kumaokobo/kudox-keyboard/README.md

# Kudox & Kudox Game Keyboards

<p align="center">
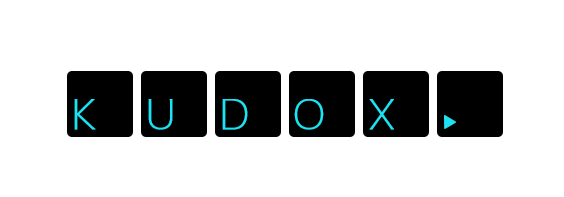
[picture p1: img/kudox.png]
Kudox logo

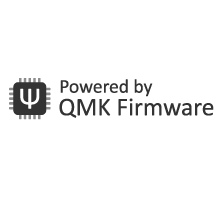
[picture p2: img/qmk-badge-light-square.png]
QMK

</p>

7x5 Row-Staggered layout keyboards.  
Powered by [QMK (Quantum Mechanical Keyboard Firmware)](https://github.com/qmk/qmk_firmware).

<p align="center">
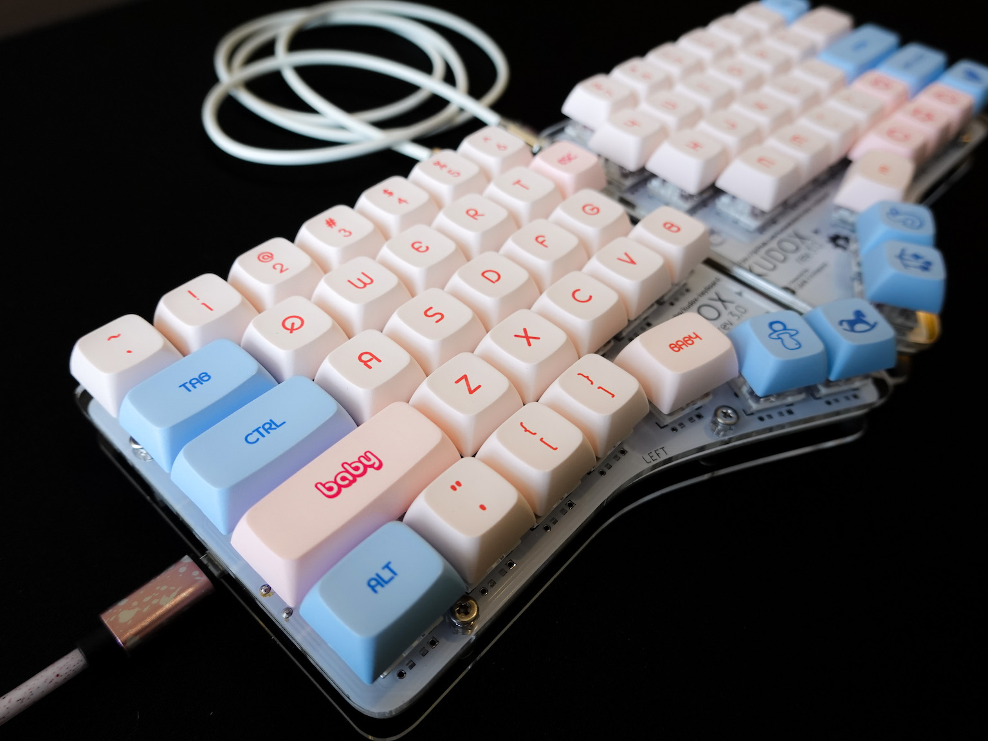
[picture p3: img/kudox-rev3-image3.jpg]
Kudox rev3 image

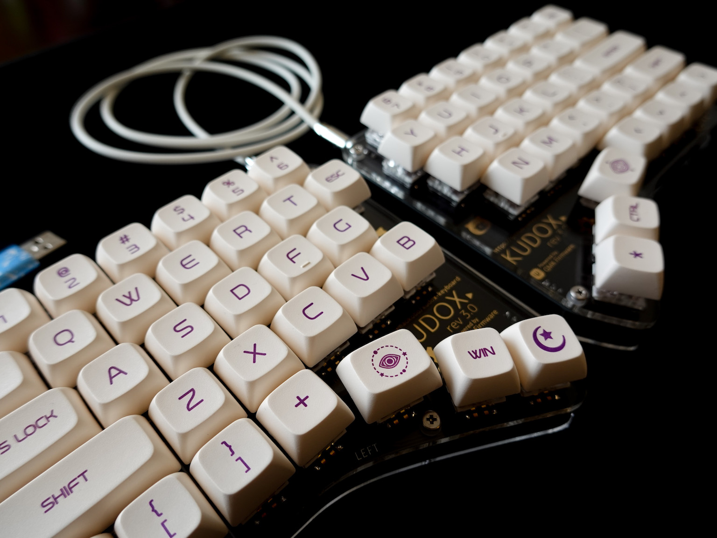
[picture p4: img/kudox-rev3-image4.jpg]
Kudox rev3 image

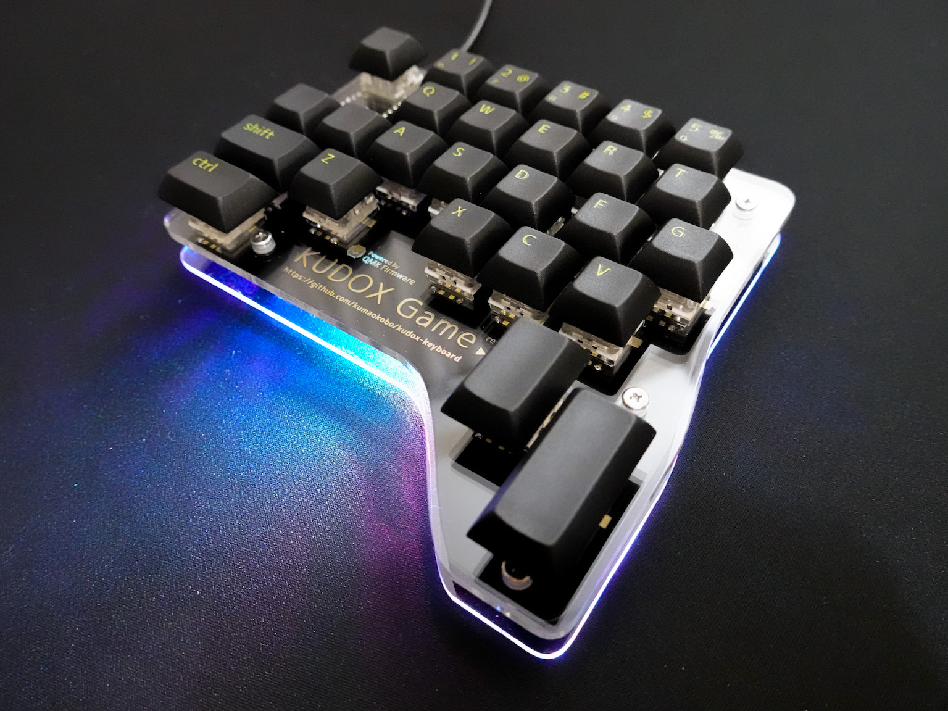
[picture p5: img/kudox-game-led1.jpg]
Kudox Game Rev2 image

</p>

## Documents

### Kudox Keyboard
- [English](./kudox/README.md)
- [Japanese](./kudox/README.ja.md)

### Kudox Game Keyboard
- [English](./kudox-game/README.md)
- [Japanese](./kudox-game/README.ja.md)

### Kudox Keyboard Columner Type
- [English](./kudox-columner/README.md)
- [Japanese](./kudox-columner/README.ja.md)

# Acknowledgements

Kudox keyboard was forked from [Redox keyboard](https://github.com/mattdibi/redox-keyboard).

# License

<br /><span xmlns:dct="http://purl.org/dc/terms/" property="dct:title">Kudox * Keyboards</span> by <a xmlns:cc="http://creativecommons.org/ns#" href="https://github.com/kumaokobo" property="cc:attributionName" rel="cc:attributionURL">Kumao Kobo</a> is licensed under a <a rel="license" href="http://creativecommons.org/licenses/by-nc-sa/4.0/">Creative Commons Attribution-NonCommercial-ShareAlike 4.0 International License</a>.
