kumaokobo/kudox-keyboard/kudox-game/README.md

# Kudox Game Keyboard

The Kudox Game is a keyboard specialized for playing game.  
It uses [QMK Firmware](https://github.com/qmk/qmk_firmware) and can be assigned `Ctrl-C`, `Ctrl-V` and so on to one key.  

**Japanese Manual is [here](README.ja.md).**

## Rev 1.0

Rev 1.0 needs to solder switches on PCB.  

<div style="display:block;margin:50px auto;">
<p align="center">
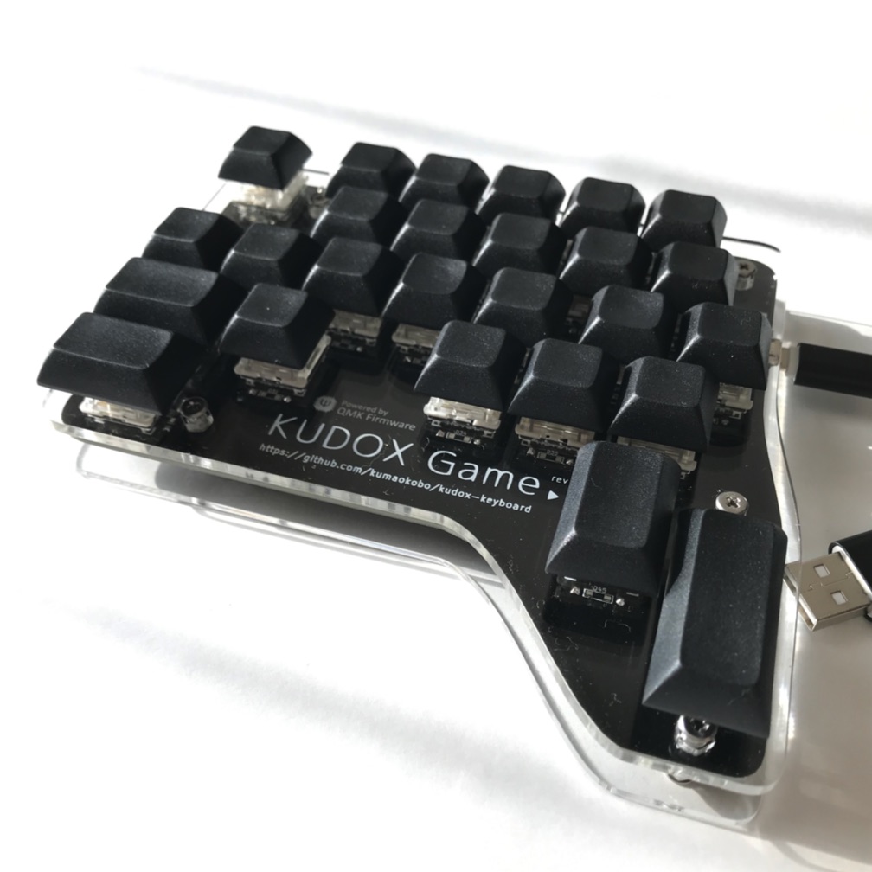
[picture p40: img/kudox-game-pcb.jpg]
Kudox Game image

</p>
</div>

- [Rev1.0 Assembly Guide](./rev1/README.md)

### Youtube: Videos

- [Inken ch](https://www.youtube.com/channel/UCXJZdip7JmW74HQHCtfYzFw) (*Japanese only*)

<p align="center">
<a href="https://www.youtube.com/watch?v=f3dFaBmC-ak">Kudox Game組み立てガイド</a>
<a href="https://www.youtube.com/watch?v=HCa4KX-FlOU">Kudox Game Firmware</a>
<a href="https://www.youtube.com/watch?v=UFQ--JORdnw">Kudox Game Playing Video</a>
</p>
</p>

## Rev 2.0

Rev 2.0 is compatible with switch hot-swapping, users can change easily switches and adjust responsibility per keys.  
As hot-swap sockets need to be soldered, it is slightly more difficult to assemble than Rev 1.0.  

<div style="display:block;margin:50px auto;">
<p align="center">
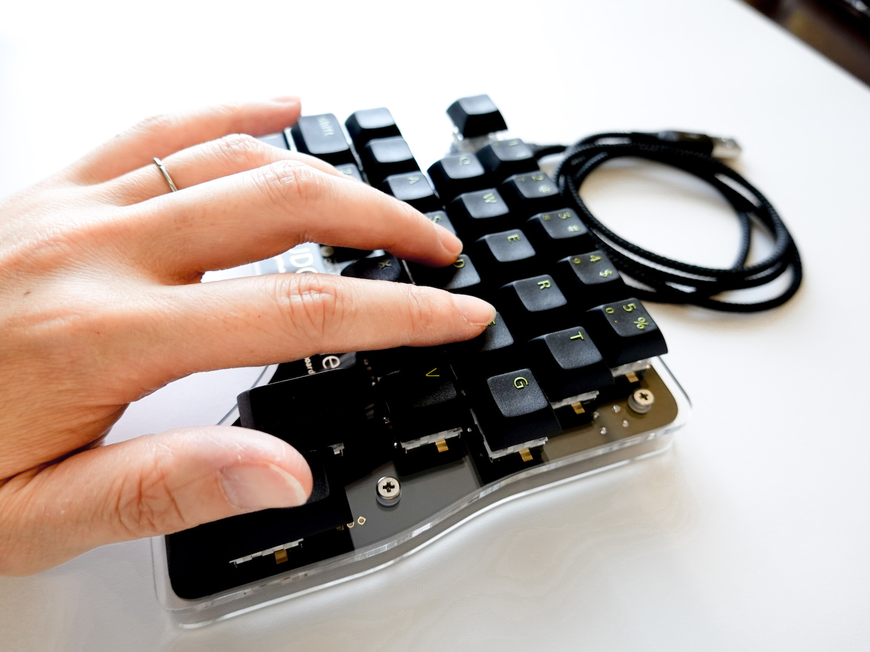
[picture p41: img/kudox-game-rev2-image1.jpg]
Kudox Game Rev2 image1

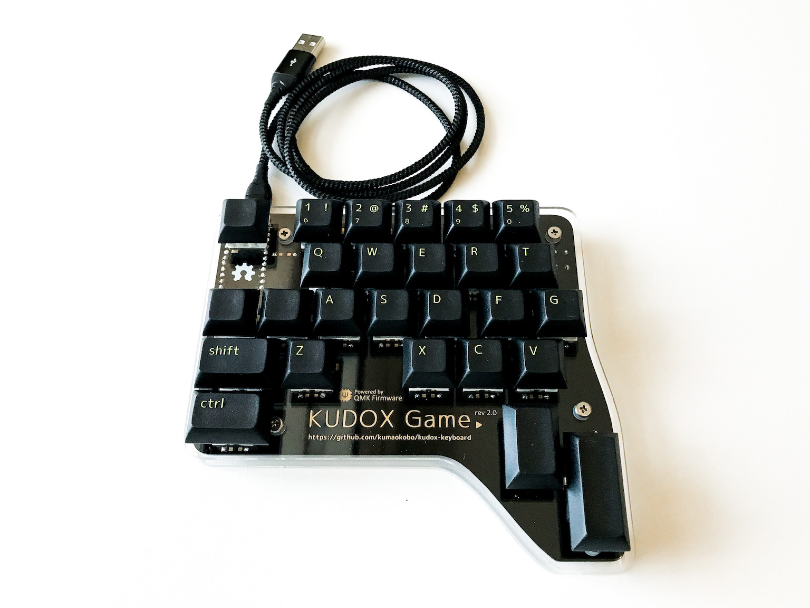
[picture p42: img/kudox-game-rev2-image2.jpg]
Kudox Game Rev2 image2

</p>
</div>

- [Rev2.0 Assembly Guide](./rev2/README.md)

# License

<br /><span xmlns:dct="http://purl.org/dc/terms/" property="dct:title">Kudox Game Keyboard</span> by <a xmlns:cc="http://creativecommons.org/ns#" href="https://github.com/kumaokobo" property="cc:attributionName" rel="cc:attributionURL">Kumao Kobo</a> is licensed under a <a rel="license" href="http://creativecommons.org/licenses/by-nc-sa/4.0/">Creative Commons Attribution-NonCommercial-ShareAlike 4.0 International License</a>.
