kumaokobo/kudox-keyboard/kudox/README.md

# Kudox Keyboard

The Kudox is the Row-Staggered split keyboard.  
**Japanese Manual is [here](README.ja.md).**

## Rev 1.0

Rev 1.0 is standard 64 key Row-Staggered split keyboard.  

<div style="display:block;margin:50px auto;">
<p align="center">
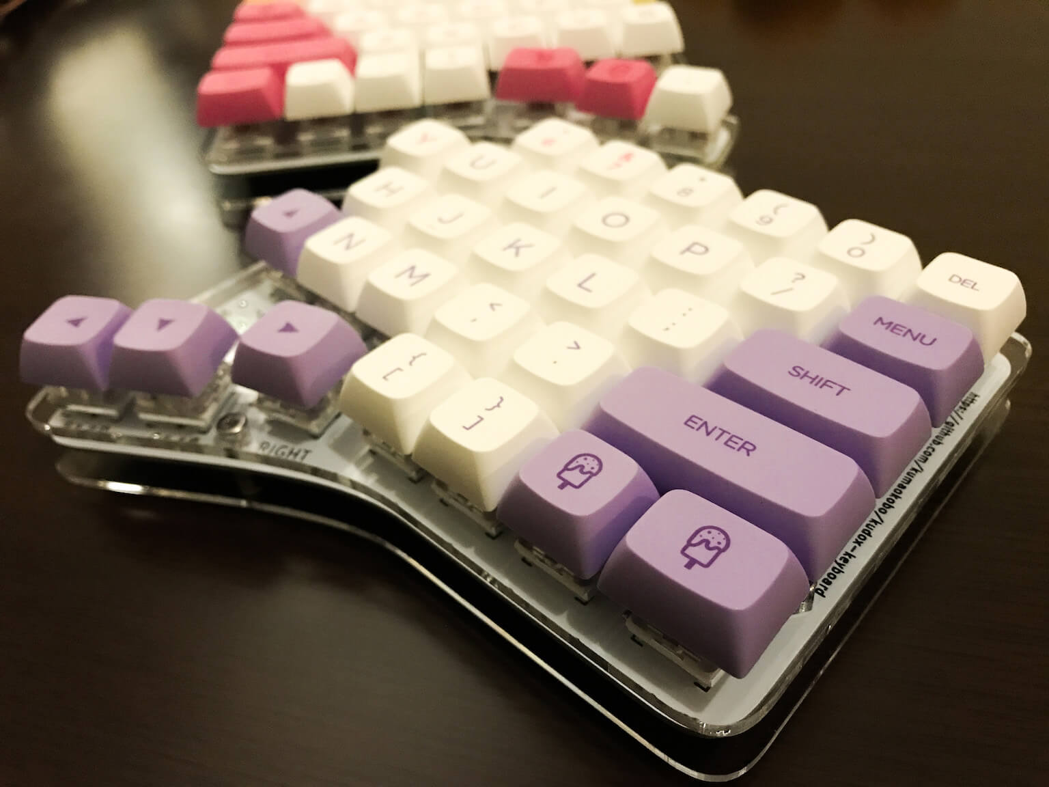
[picture p43: img/kudox-pcb.jpg]
Kudox image

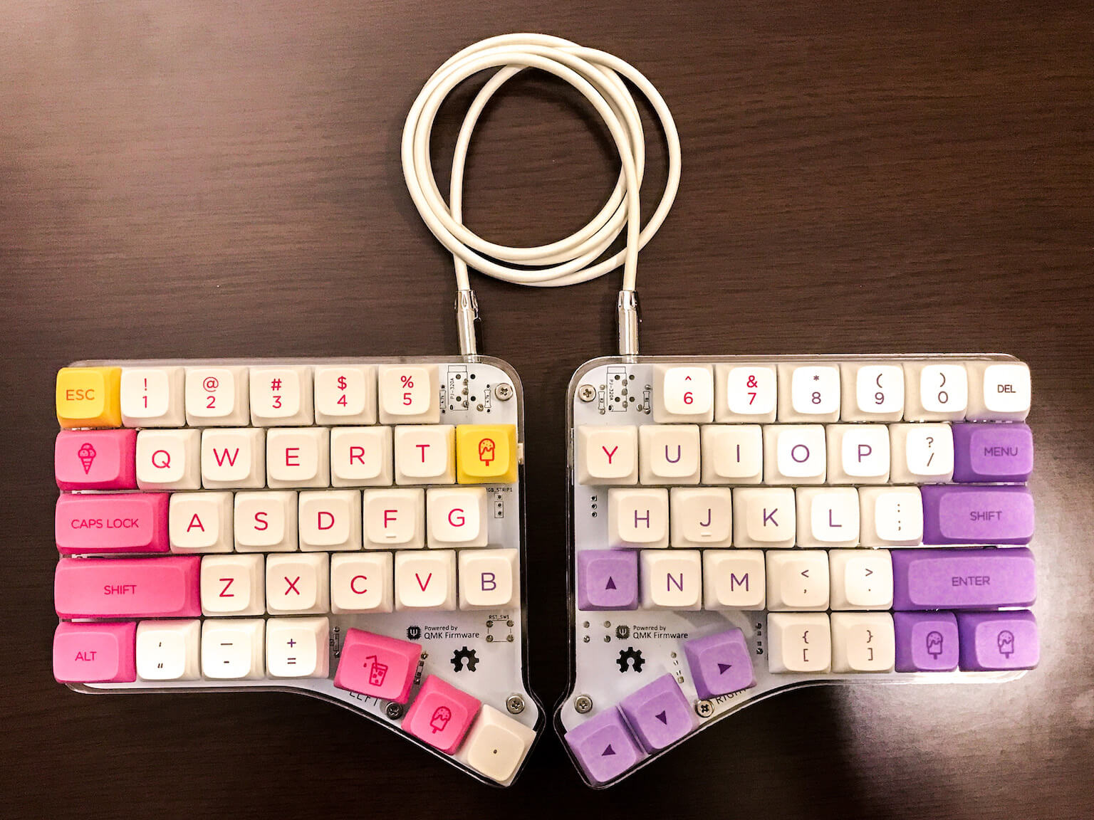
[picture p44: img/kudox-image-rev1.jpg]
Kudox image1

</p>
</div>

- [Rev1.0 Assembly Guide](./rev1/README.md)

## Rev 2.0

Rev 2.0 is hot-swappable 66 key split keyboard.  
As hot-swap sockets need to be soldered, it is slightly more difficult to assemble than Rev 1.0.  

<div style="display:block;margin:50px auto;">
<p align="center">
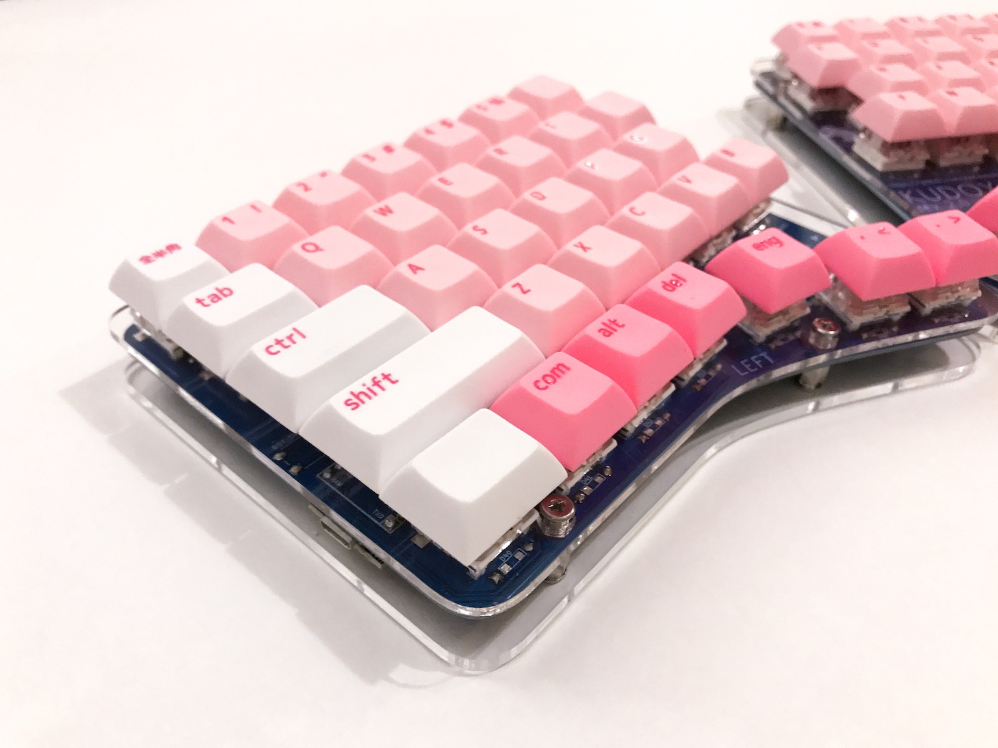
[picture p45: img/kudox-rev2-image1.jpg]
Kudox rev2 image1

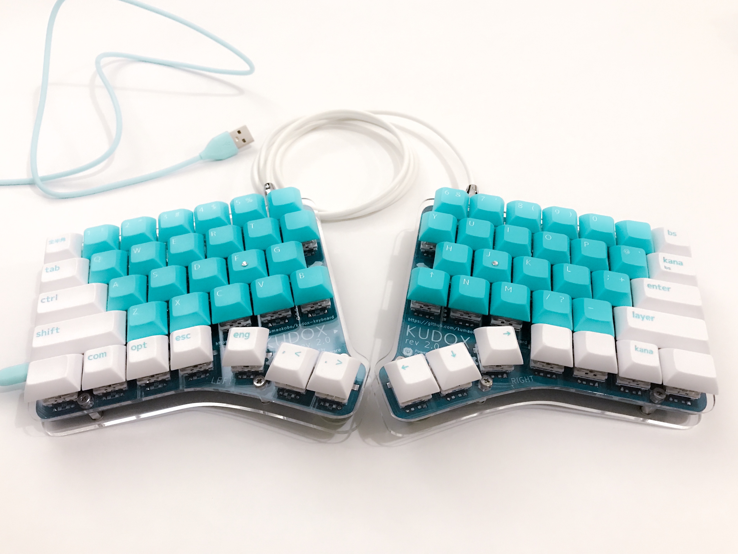
[picture p46: img/kudox-rev2-image2.jpg]
Kudox rev2 image2

</p>
</div>

- [Rev2.0 Assembly Guide](./rev2/README.md)

## Rev 3.0

Rev 3.0 supports both hot swap sockets and direct switch mounting.  
Also, we divided the board design for right hand and left hand.  
For this reason, the key columns become more normal row-staggered.  

<div style="display:block;margin:50px auto;">
<p align="center">
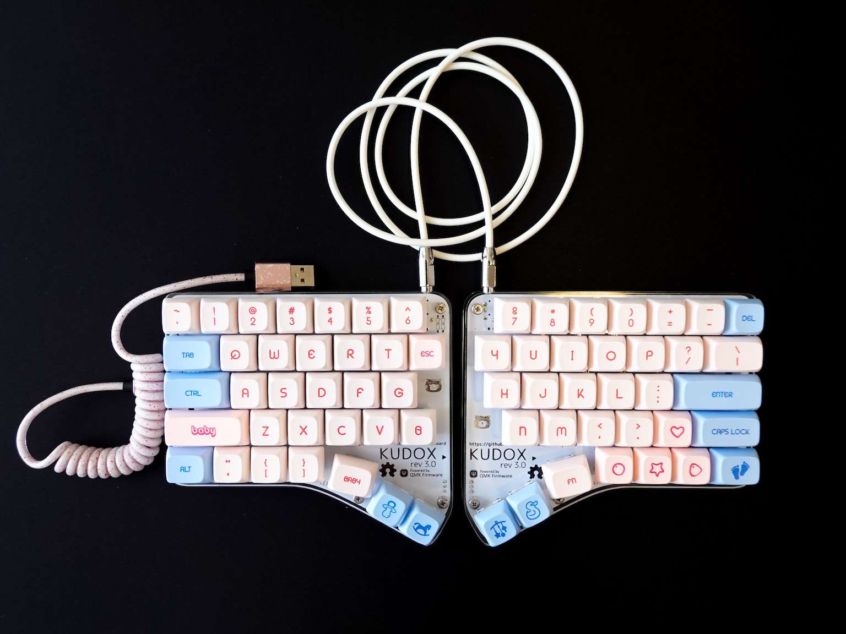
[picture p47: img/kudox-rev3-image1.jpg]
Kudox rev3 image1

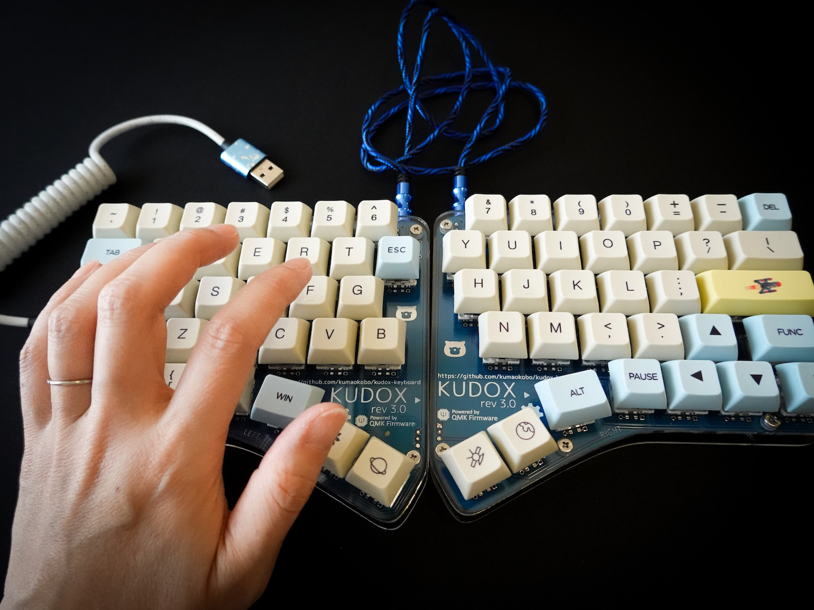
[picture p48: img/kudox-rev3-image2.jpg]
Kudox rev3 image2

</p>
</div>

- [Rev3.0 Assembly Guide](./rev3/README.md)

### Video guides

- [Inken ch](https://www.youtube.com/channel/UCXJZdip7JmW74HQHCtfYzFw) (japanese only)

<p align="center">
<a href="https://www.youtube.com/watch?v=6zZAXjMQ80E">Kudox assembly guide</a>
<a href="https://www.youtube.com/watch?v=HCa4KX-FlOU">Kudox Firmware</a>
</p>

# License

<br /><span xmlns:dct="http://purl.org/dc/terms/" property="dct:title">Kudox Keyboard</span> by <a xmlns:cc="http://creativecommons.org/ns#" href="https://github.com/kumaokobo" property="cc:attributionName" rel="cc:attributionURL">Kumao Kobo</a> is licensed under a <a rel="license" href="http://creativecommons.org/licenses/by-nc-sa/4.0/">Creative Commons Attribution-NonCommercial-ShareAlike 4.0 International License</a>.
