kumaokobo/kudox-keyboard/kudox-game/rev2/README.ja.md

# Kudox Game Keyboard Rev2.0

Kudox Game Rev2.0 は ゲーム・プレイに特化した片手用キーボードです.  
スイッチ・ホットスワップを採用し, スイッチの入れ替えを容易にすることで, キー毎に反応のし易さや打鍵感を調整できるようにしました.  
また キー・コードを自由にレイアウトできる [QMK Firmware](https://github.com/qmk/qmk_firmware) を利用しているので, `Ctrl-C` や `Ctrl-V` などの合成キーを1キーに割り当てられるようになっています.  

**English Manual is [here](README.md).**

<p align="center">
Kudox Game image&nbsp;
Kudox Game Rev2
</p>

## Summary

  - [必要な部品](#必要な部品)
  - [組み立てガイド](#組み立てガイド)
  - [LEDテープの取り付け](#LEDテープの取り付け)
  - [ファームウェア](#ファームウェア)
    - [コンパイル＆書き込みコマンド](#コンパイル＆書き込みコマンド)
    - [VIAを使ったキーマップ変更](#VIAを使ったキーマップ変更)

## 必要な部品

| 数量 | 項目 | 備考 |
|----:|---|---|
| 1 | Kudox Game Rev2 | |
|  26 | 1N4148 ダイオード | SMD ダイオードでも可. |
|  26 | [Kailh PCB Scoket](https://www.kailhswitch.com/mechanical-keyboard-switches/box-switches/mechanical-keyboard-switches-kailh-pcb-socket.html) | Cherry MX 互換タイプの方 |
| 1 | タクトスイッチ | 6mm x 6mm x 4.3mm サイズのもの. |
| 1 | Arduino ProMicro | マイコン: ATMega32U4 |
| 1 | USB micro ケーブル | 家に落ちているもので可. |
| 1 | ケース | |
| 5 | ネジ M3 x 10mm | M3 |
| 5 | ネジ M3 x  5mm | M3 |
| 5 | スペーサー | M3 |
| 5 | ワッシャー | M3 |
|  26 | Cherry MX 互換スイッチ | お好みで...💕 |
|  26 | Cherry MX 互換 キーキャップ | 3x 1.5u, 1x 2u, 22x 1u |

キーキャップとスイッチ以外の全てを含む [Kudox Game Rev2 基本セット](https://manage.booth.pm/items/1917685) を [BOOTH](https://kumaokobo.booth.pm/) にて販売しています.  

## 組み立てガイド

<p align="center">
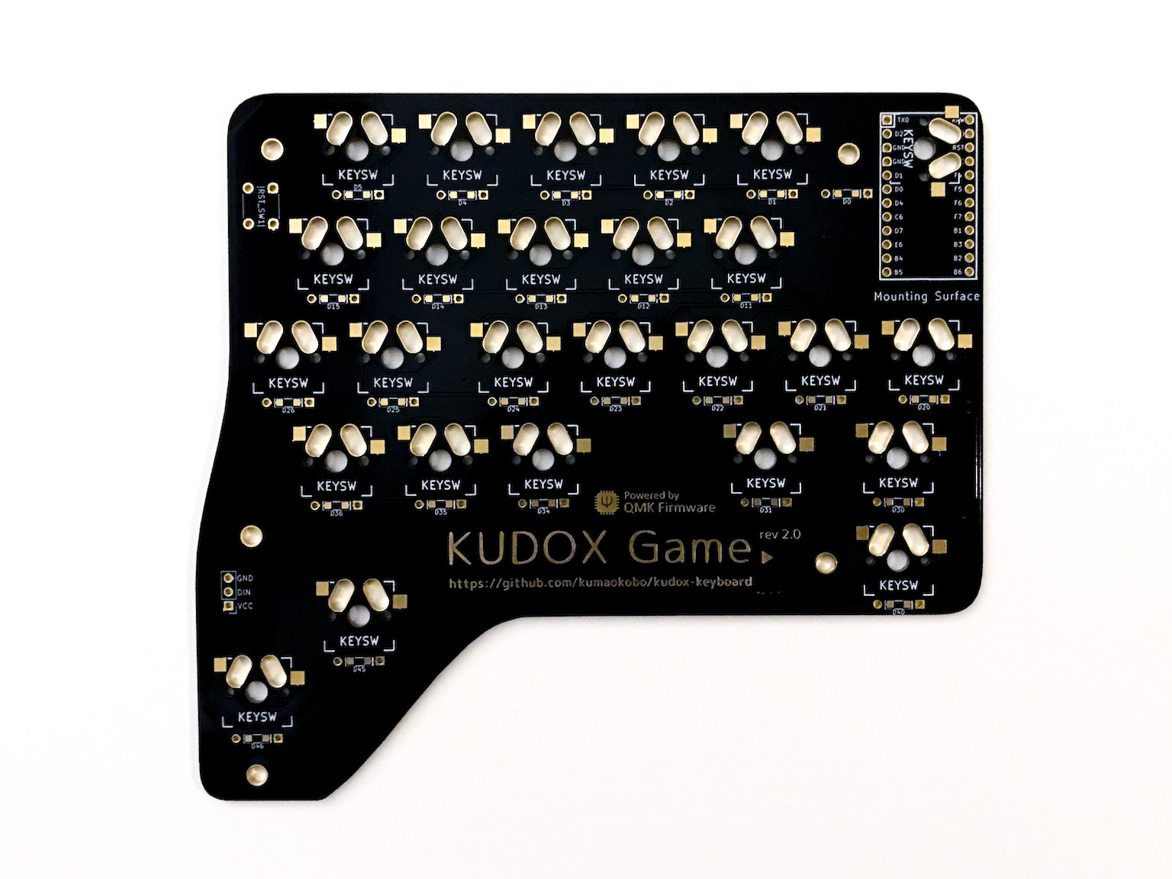
[picture p49: img/kudox-game-rev2-pcb.jpg]
Kudox Game Rev2 PCB

</p>

- PCB の `Mounting Surface` と記載のある側に電子部品をはんだ付けします:
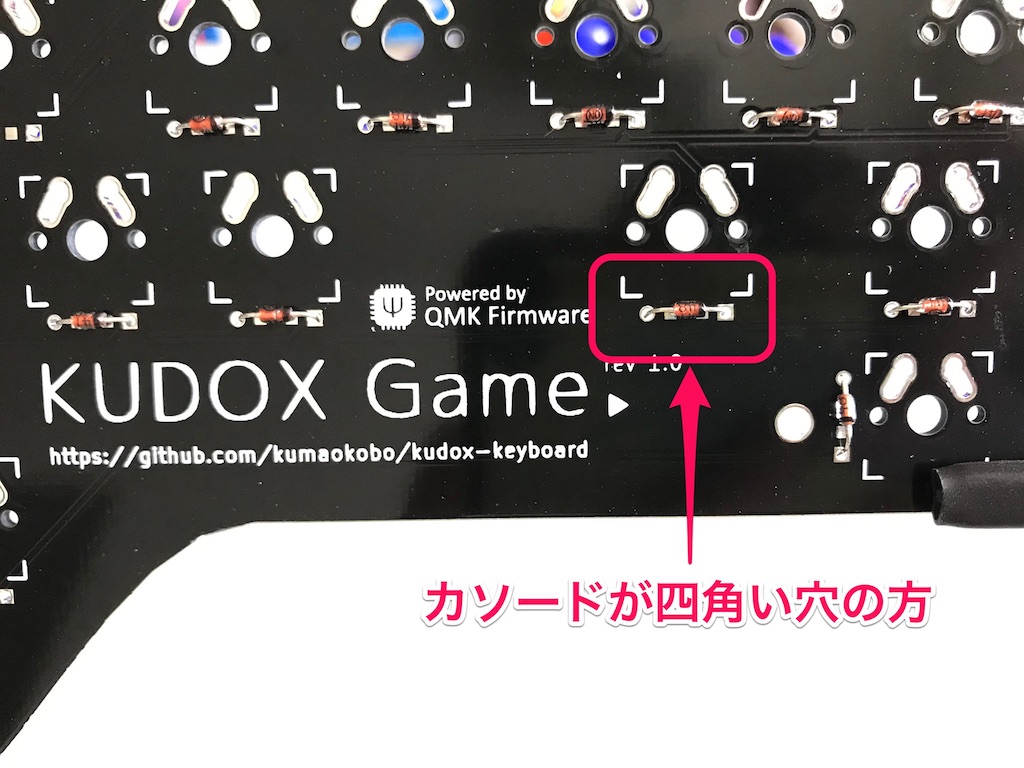
[picture p50: img/kudox-game-diode.jpg]
Kudox Game diode
  1. 1N4148ダイオード (向きがあります. カソードが四角い穴側にくるように差します)<br/>*多くのダイオードではカソード側に線などが入っています*
  2. タクトスイッチ
  3. ホットスワップ・ソケット<div>soldering hot swap sockets</div>下記の動画で詳しく紹介しています: <br/><div><a href="https://www.youtube.com/watch?v=uHqkW0cQ80I">ホットスワップソケットの付け方</a></div>[[YouTube] インケンch: ホットスワップソケットの付け方](https://www.youtube.com/watch?v=uHqkW0cQ80I)<br/>クリームはんだでリフローして頂いてももちろん大丈夫です.
  4. ProMicro の ピン・ヘッダ
- パーツの足をカットします.  
  *※ 特に ProMicro のピン・ヘッダはスイッチに干渉しやすいのでできるだけ短くカットしてください*
- ProMicro を ピン・ヘッダにはんだ付けします.  
  <span><em>※ ProMicro は表向き(チップが見えるように)に実装します. (rev1と逆になります)</em></span>
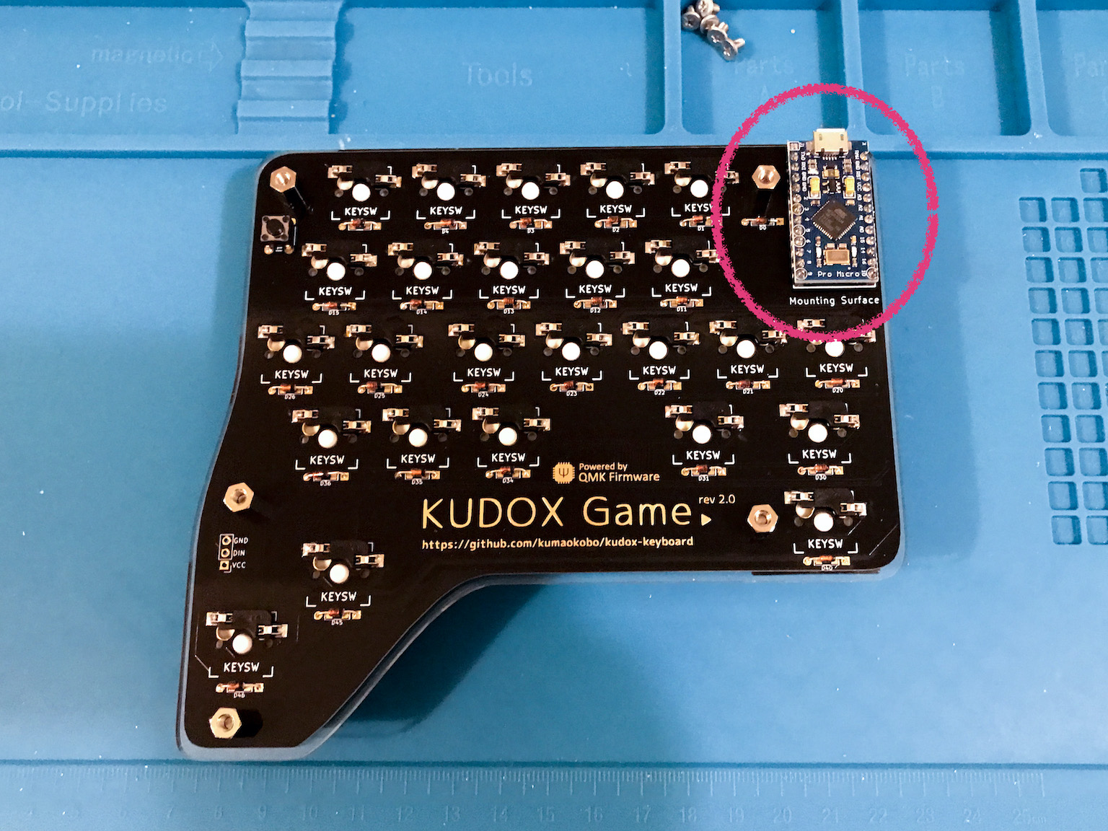
[picture p51: img/kudox-game-rev2-promicro.jpg]
Kudox Game Rev2 ProMicro
  
- PCB に上部ケースを取り付けます.  
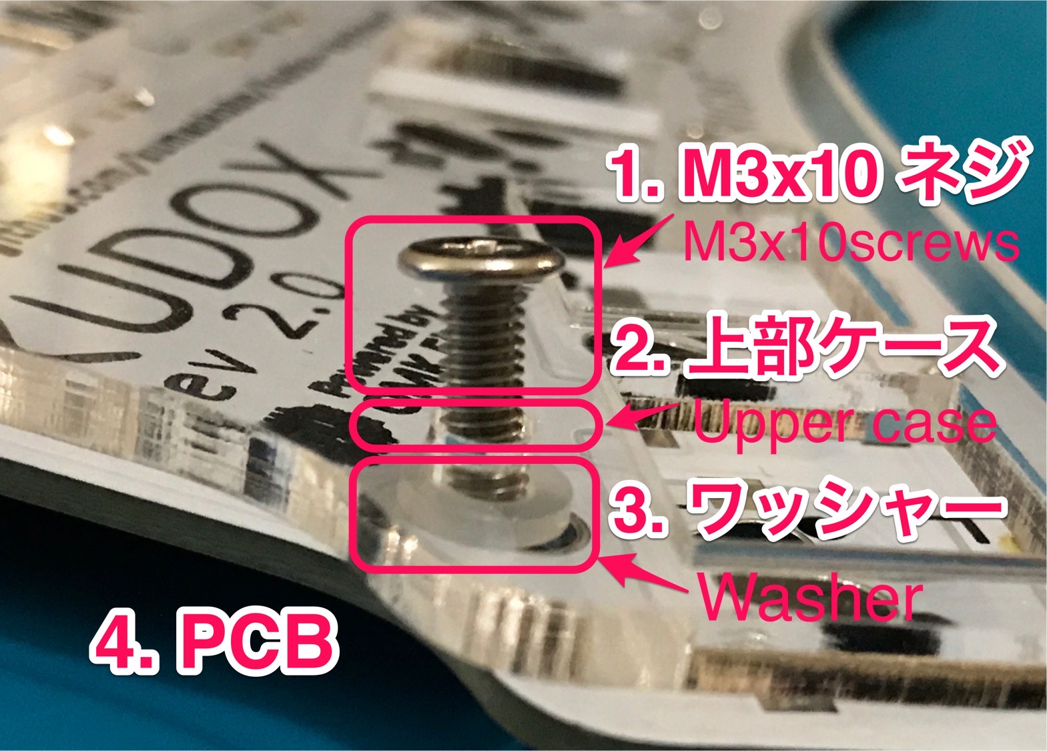
[picture p52: img/kudox-case-hotswap.jpg]
Kudox Game Case
  M3ネジ(10mm) → 上部ケース → M3ワッシャー → PCB → スペーサー の順番に取り付けます.<br/>
- M3ネジ(5mm)で下部ケースとスペーサーを止めます.
- スイッチを嵌めて完成です.<div>
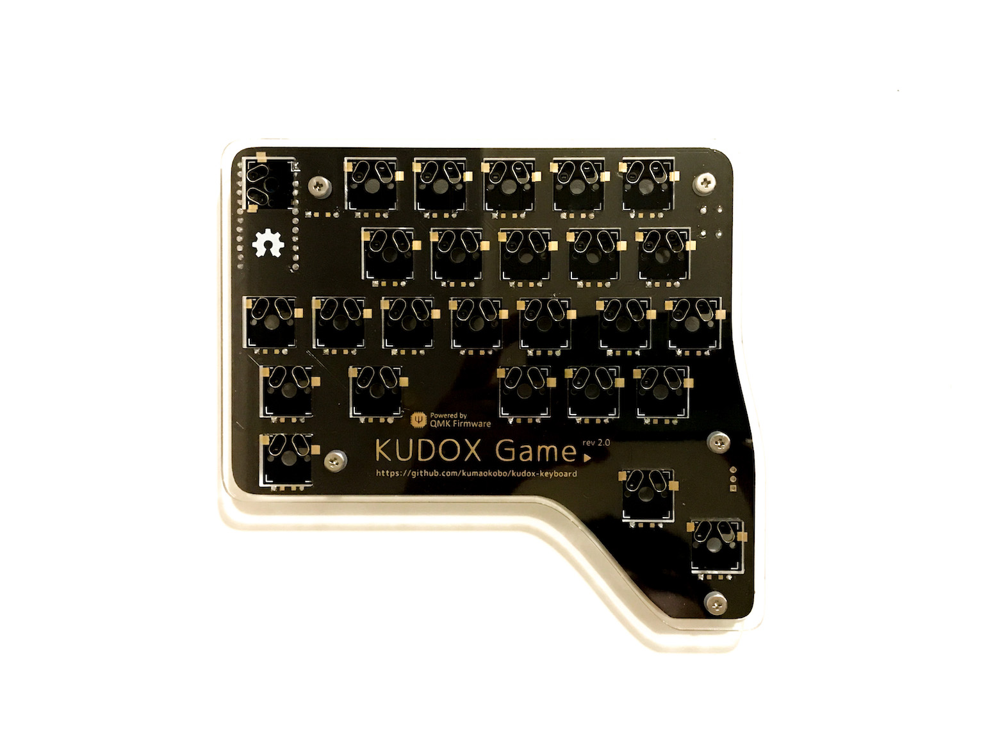
[picture p53: img/kudox-game-rev2-assembly-case-1.jpg]
assembly kudox game rev2 case 1
  <span>&nbsp;&nbsp;</span>
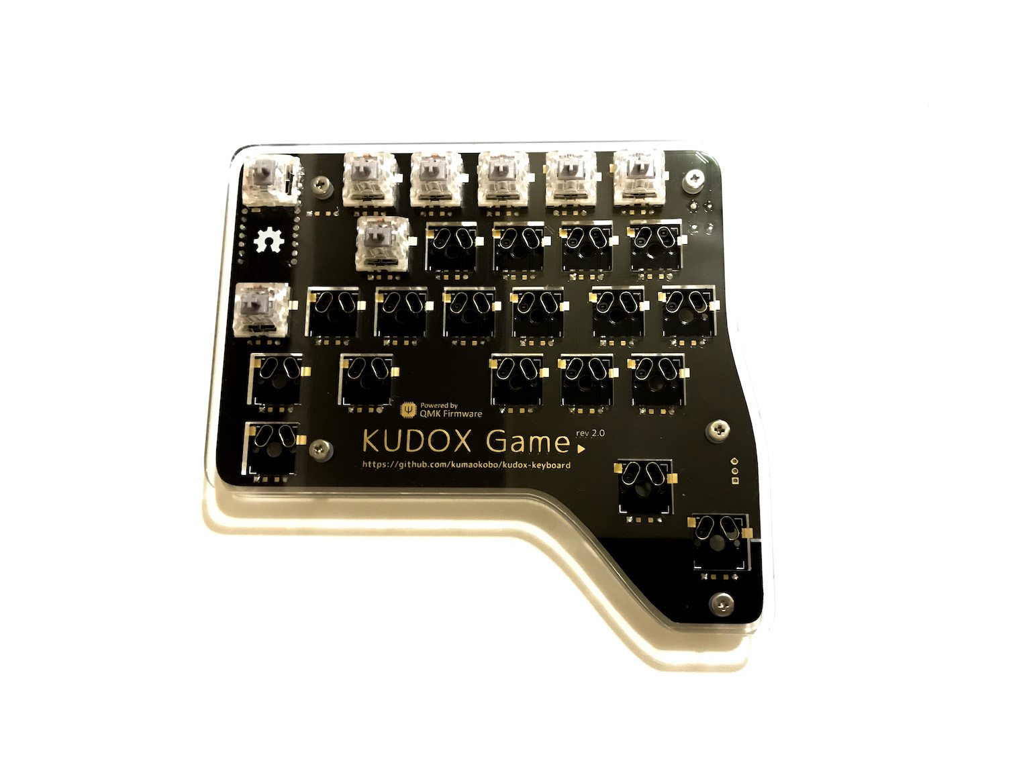
[picture p54: img/kudox-game-rev2-assembly-case-2.jpg]
assembly kudox game rev2 case 2
  
</div>

### Youtube: 組み立てガイド & プレイ動画

- [インケンch](https://www.youtube.com/channel/UCXJZdip7JmW74HQHCtfYzFw)

<p align="center">
<a href="https://www.youtube.com/watch?v=f3dFaBmC-ak">Kudox Game組み立てガイド</a>
<a href="https://www.youtube.com/watch?v=HCa4KX-FlOU">Kudox Game Firmware</a>
<a href="https://www.youtube.com/watch?v=UFQ--JORdnw">Kudox Game Playing Video</a>
</p>

動画ではちょっとしたコツなども紹介しています.  
*動画は `rev1` のものですが、ホットスワップ・ソケットと ProMicro 向き以外は概ね同じです.*

## LEDテープの取り付け

▶ [こちら](LED.ja.md)をご覧ください.

## ファームウェア

<p align="center">
qmk
</p>

Kudox Game Keyboard は [QMK Firmware](https://github.com/qmk/qmk_firmware) を利用しています.  
QMK Firmware のインストールは [こちら](https://docs.qmk.fm/#/newbs_getting_started) をご覧ください.  

### コンパイル＆書き込みコマンド

ProMicro と PC をUSBケーブルで接続し、下記コマンド を実行します.

```sh
$ cd path/to/qmk_firmware
$ qmk compile -kb kudox_game/rev2 -km default
$ qmk flash -kb kudox_game/rev2 -km default
```

文字入力可能なことを確認します.  

キー・コードを変更する場合は [kudox_game/keymaps/default/keymap.c](https://github.com/qmk/qmk_firmware/blob/master/keyboards/kudox_game/keymaps/default/keymap.c) を変更し, 再度書き込みをおこないます.  
キー・コード設定は [Qmk Firmware](https://github.com/qmk/qmk_firmware) の [keycodes](https://github.com/qmk/qmk_firmware/blob/master/docs/keycodes.md) をご参照くださいませ.  

### VIAを使ったキーマップ変更

<p align="center">
qmk</br>
<a href="https://caniusevia.com/">the-via: https://caniusevia.com/</a>
</p>

#### 1. VIA 対応ファームの書き込み

kudox_game/rev2/rule.mk を作成し `VIA_ENABLE = yes` を記述します.

```sh
$ vi qmk_firmware/keyboards/kumaokobo/kudox_game/rev2/rules.mk
~
VIA_ENABLE = yes
~
```

VIA に対応したファームウェアを書き込みます.

```sh
$ git clone https://github.com/qmk/qmk_userspace.git
$ qmk config user.overlay_dir="$(realpath qmk_userspace)"
$ cd path/to/qmk_firmware
$ qmk userspace-add -kb kudox_game/rev2 -km via
$ qmk compile -kb kudox_game/rev2 -km via
$ qmk flash -kb kudox_game/rev2 -km via
```

#### 2. VIA のインストール

ブラウザで VIA を開きます.
- [https://usevia.app/](https://usevia.app/)

#### 3. キーボード設定ファイルの読み込み

VIA の `DESIGN` -> `Load Draft Definition` から 下記のjsonを読み込みます.  
キーボードを PC に接続し, `CONFIGURE` -> `Authorize device` を行います.
- [kudox_game_rev2.json](https://github.com/kumaokobo/kudox-keyboard/blob/master/kudox-game/rev2/kudox_game_rev2.json)

#### 4. キーマップの変更

VIA上でキーマップを変更します.

<p align="center">
via operation
</p>

> VIA上でキーを選択したりLED設定を変えたりすると即座に変更が反映されます. 保存して反映, という手順は必要ありません.

### オンラインGUIのファームウェア生成ツール

[Qmk Firmware](https://github.com/qmk/qmk_firmware) はオンラインでQMKのファームウェアを生成することができる [QMK Configurator](https://config.qmk.fm/) というツールを公開しています.  

<p align="center">
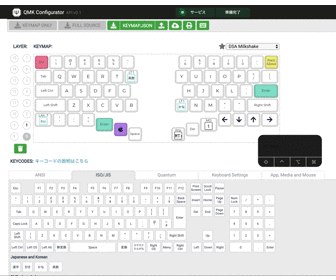
[picture p55: img/qmk_configurator.gif]
qmk configurator

</p>

*QMK Configuratorの詳細な使い方はいろいろなサイトで詳しく解説されているので, そちらをご参照くださいませ.*  
*残念ながらJIS配列の生成はできないようです.*  

## レイアウト

<p align="center">
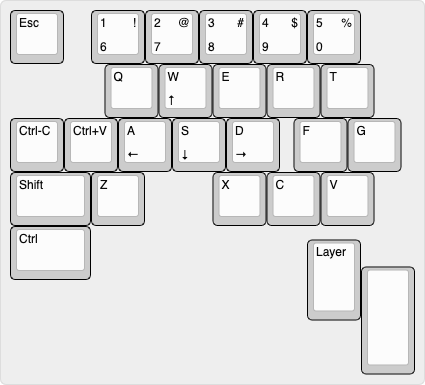
[picture p56: img/kudox-game-layout-rev2.png]
Kudox Game Rev2.0 layout

</p>
<p align="center">
<em><a href="http://www.keyboard-layout-editor.com/">http://www.keyboard-layout-editor.com/</a></em>
</p>

- [KLE Layout permalink](http://www.keyboard-layout-editor.com/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)
