kumaokobo/kudox-keyboard/kudox-game/rev2/README.md

# Kudox Game Keyboard Rev2.0

The Kudox Game Rev2.0 is a keyboard specialized for playing game.  
Because it is compatible with switch hot-swapping, users can change easily switches and adjust responsibility per keys.  
Also it uses [QMK Firmware](https://github.com/qmk/qmk_firmware) and can be assigned `Ctrl-C`, `Ctrl-V` and so on to one key.  

**Japanese Manual is [here](README.ja.md).**

<p align="center">
Kudox Game image&nbsp;
Kudox Game Rev2
</p>

## Summary

  - [Bill of materials](#bill-of-materials)
  - [Assembly guide](#assembly-guide)
  - [Assembly LED strips](#assembly-led-strips)
  - [Firmware](#firmware)
    - [VIA Support](#via-support)

## Bill of materials

| Qty | Item | Notes |
|----:|---|---|
| 1 | Kudox Game PCB | |
|  26 | 1N4148 diodes | SMD diodes can also be used |
|  26 | [Kailh PCB Scoket](https://www.kailhswitch.com/mechanical-keyboard-switches/box-switches/mechanical-keyboard-switches-kailh-pcb-socket.html) | Cherry MX compatible |
| 1 | Through hole momentary switch | Dimensions 6mm x 6mm x 4.3mm |
| 1 | Arduino Pro Micro | ATMega32U4 |
| 1 | USB micro cable | |
| 1 | Case | |
| 5 | Screws M3 x 10mm | M3 |
| 5 | Screws M3 x  5mm | M3 |
| 5 | Spacers | M3 x 7mm |
| 5 | Washers | M3 |
|  26 | Cherry MX compatible switches | |
|  26 | Cherry MX compatible keycaps | 3x 1.5u keycaps, 1x 2u keycap, 22x 1u keycaps |

[Kudox Game Rev2 Basic](https://manage.booth.pm/items/1917685) is on sale at [BOOTH](https://kumaokobo.booth.pm/) (**NOT** including switches and keycaps).  

## Assembly guide

<p align="center">
Kudox Game Rev2 PCB
</p>

### Installation steps:

- Solder components:
  1. Solder 1N4148 diodes. Put the cathode in the square hole.<br/><div>Kudox Game diode</div>
  2. Solder a momentary switch.
  3. Solder PCB hot-swap sockets.<div>soldering hot swap sockets</div>How to solder hot-swap sockets: <br/><div><a href="https://www.youtube.com/watch?v=uHqkW0cQ80I">How to solder hot-swap sockets</a></div>[YouTube:Inken ch:How to solder hot-swap sockets](https://www.youtube.com/watch?v=uHqkW0cQ80I)
  4. Solder the Pro Micro header pins.
- Cuts legs of parts.  
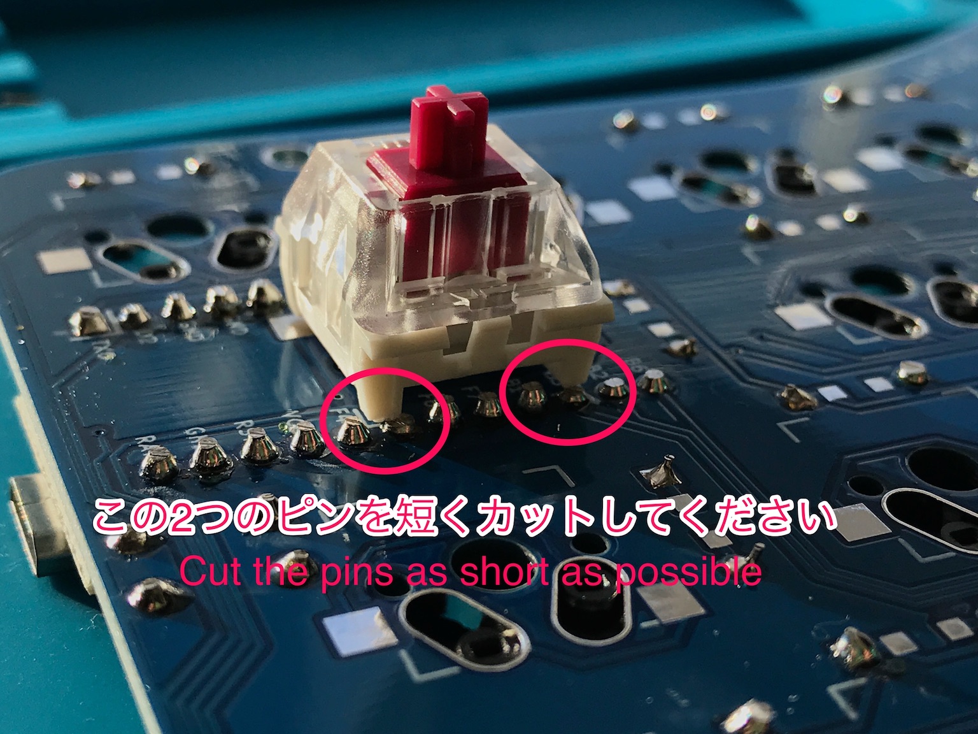
[picture p57: img/cuts-pins.jpg]
cuts pins
  *Specially, pin-headers of Pro Micro needs to be cut as short as possible.*
- Solder Pro Micros to the header pins **face up**.<div>Kudox Game Rev2 ProMicro</div>
- Install upper cases to PCBs.  
  M3x10 screws → upper case → M3 washers → PCB → spacers.<br/><div>Kudox Game Case</div>
- Install lower cases.
- Fit switches to the upper cases.<div>
  assembly kudox game rev2 case 1<span>&nbsp;&nbsp;</span>
  assembly kudox game rev2 case 2
</div>

### Video guides

- [Inken ch](https://www.youtube.com/channel/UCXJZdip7JmW74HQHCtfYzFw) (japanese only)

<p align="center">
<a href="https://www.youtube.com/watch?v=f3dFaBmC-ak">Kudox Game Building Guide</a>
<a href="https://www.youtube.com/watch?v=HCa4KX-FlOU">Kudox Game Firmware</a>
<a href="https://www.youtube.com/watch?v=UFQ--JORdnw">Kudox Game Playing Video</a>
</p>

## Assembly LED strips

▶ The guide is [here](LED.md).

## Firmware

<p align="center">
qmk
</p>

Kudox Game keyboard uses [QMK Firmware](https://github.com/qmk/qmk_firmware) for its firmware.  
Follow the QMK installation instructions [here](https://docs.qmk.fm/#/newbs_getting_started), then compile and burn the firmware as follows:  

```sh
$ cd path/to/qmk_firmware
$ qmk compile -kb kudox_game/rev2 -km default
$ qmk flash -kb kudox_game/rev2 -km default
```

Confirm to be able to input chars.  

In case of changing the keymap, modify [kudox_game/keymaps/default/keymap.c](https://github.com/qmk/qmk_firmware/blob/master/keyboards/kudox_game/keymaps/default/keymap.c) and re-write firmware.  
You can see keycodes at [keycodes](https://github.com/qmk/qmk_firmware/blob/master/docs/keycodes.md) on [Qmk Firmware](https://github.com/qmk/qmk_firmware).  

### VIA Support

<p align="center">
qmk</br>
<a href="https://caniusevia.com/">the-via: https://caniusevia.com/</a>
</p>

Burn the firmware compatible with [VIA](https://caniusevia.com/).

Write kudox_game/rev2/rule.mk `VIA_ENABLE = yes`
```sh
$ vi qmk_firmware/keyboards/kumaokobo/kudox_game/rev2/rules.mk
~
VIA_ENABLE = yes
~
```

Compile and flash firmware.

```sh
$ git clone https://github.com/qmk/qmk_userspace.git
$ qmk config user.overlay_dir="$(realpath qmk_userspace)"
$ cd path/to/qmk_firmware
$ qmk userspace-add -kb kudox_game/rev2 -km via
$ qmk compile -kb kudox_game/rev2 -km via
$ qmk flash -kb kudox_game/rev2 -km via
```

Go to VIA by your browser.
- [https://usevia.app/](https://usevia.app/)

Select `DESIGN` -> `Load Draft Definition` on VIA and load the json below:
- [kudox_game_rev2.json](https://github.com/kumaokobo/kudox-keyboard/blob/master/kudox-game/rev2/kudox_game_rev2.json)

Plug the keyboard in your PC, and `CONFIGURE` -> `Authorize device`.

Change keymap by VIA.

<p align="center">
via operation
</p>

### Online GUI

The [QMK Configurator](https://config.qmk.fm/) is an online graphical user interface that generates QMK Firmware hex files.

<p align="center">
qmk configurator
</p>

## Layout

<p align="center">
Kudox rev1.0 layout
</p>
<p align="center">
<em><a href="http://www.keyboard-layout-editor.com/">http://www.keyboard-layout-editor.com/</a></em>
</p>

- [KLE Layout permalink](http://www.keyboard-layout-editor.com/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)
