kumaokobo/kudox-keyboard/kudox/rev3/LED.md

# Assembly LED strips (WS2812B)

**Japanese Guide is [here](LED.ja.md).**

<div>
kudox led image
</div>

## Parts

<div>
led parts
</div>

- WS2812B LEDs 7 x 2
- Lead Wires x 7 (*Recommend: Five lead wires attached with connector*)
- Angle-3 Pin Headers x 2
- Insulation tape
- Soldered PCB

The guide indicate Colors below:
```
VCC: red
GND: black
DIN: yellow
DO : green
```

**The resisters on Kudox PCB should be removed if you install LED strips.**

## 1. Solder LED strips lead wires.

<div>led soldered</div>

Solder each `5V` , `DIN` , `GND` on 1st LED lead wires.  
Solder `DO` on opposit side of 1st LED a lead wire.  
<br/>
Solder `DIN` on 2nd LED a lead wire.  
Solder each `5V` , `GND` on opposit side of 2nd LED lead wires.  

> Please consider using soldering flux. Often it is difficult to solder LED strip.

*LED is vulnerable to heat, so they may break if exposed to high heat for a long time.*  

## 2. Insulate LED.

<div>led insulation</div>

Insulate the soldered points using tape or tube.  

## 3. Solder TRRS-Jacks the lead wires.

<div>led wired&nbsp;&nbsp;led wired</div>

Solder TRRS-Jacks the wires drawn each `DO` and `DIN` of LED strips.

- Left hand side: Using LED strip solderd `5V` , `DIN` , `GND` .
- Right hand side: Using LED strip solderd `5V` , `GND` .

```
Left hand DIN -> LED -> DO -> TRRS -> Right hand TRRS -> DO -> LED
```

## 4. Solder PCBs Pin Headers.

<div>led pin header</div>

Solder Angle-3 Pin Headers at point of `RGB` .  

## 5. Connect Lead Wires to Pin Headers.

<div>led wired</div>

`RGB` Pin Header is below:

```
VCC
GND
Data-IN
```
