kumaokobo/kudox-keyboard/kudox/README.ja.md

# Kudox Keyboard

Kudox は Row-Staggered 配列の左右分離キーボードです.  
**English Manual is [here](README.md).**

## Rev 1.0

Rev 1.0 は 64キーのスタンダードなRow-Staggered な分離キーボードです.  

<div style="display:block;margin:50px auto;">
<p align="center">
Kudox image
Kudox image1
</p>
</div>

- [Rev1.0の組み立てマニュアル](./rev1/README.ja.md)

## Rev 2.0

Rev 2.0 では スイッチの フットプリント に スイッチホットスワップ を採用しました.  
また キー数が2つ増え 66キーになりました.  
ホットスワップ・ソケットのはんだ付けが必要なため、 Rev 1.0 に比べてやや組み立て難易度が上がります.  

<div style="display:block;margin:50px auto;">
<p align="center">
Kudox rev2 image1
Kudox rev2 image2
</p>
</div>

- [Rev2.0の組み立てマニュアル](./rev2/README.ja.md)

## Rev 3.0

Rev 3.0 から ホットスワップ・ソケット / スイッチ直付けの両方に対応たフットプリントを採用しました.  
また, 右手用と左手用で基板設計を分け, キーのずれ方を *Normal staggerrd* に寄せました.  

<div style="display:block;margin:50px auto;">
<p align="center">
Kudox rev3 image1
Kudox rev3 image2
</p>
</div>

- [Rev3.0の組み立てマニュアル](./rev3/README.ja.md)

## 組み立て方を動画で紹介

- [インケンch](https://www.youtube.com/channel/UCXJZdip7JmW74HQHCtfYzFw)

<p align="center">
<a href="https://www.youtube.com/watch?v=6zZAXjMQ80E">Kudox組み立てガイド</a>
<a href="https://www.youtube.com/watch?v=HCa4KX-FlOU">Kudox Firmware</a>
</p>

動画ではちょっとしたコツなども紹介しています.

# License

<br /><span xmlns:dct="http://purl.org/dc/terms/" property="dct:title">Kudox Keyboard</span> by <a xmlns:cc="http://creativecommons.org/ns#" href="https://github.com/kumaokobo" property="cc:attributionName" rel="cc:attributionURL">Kumao Kobo</a> is licensed under a <a rel="license" href="http://creativecommons.org/licenses/by-nc-sa/4.0/">Creative Commons Attribution-NonCommercial-ShareAlike 4.0 International License</a>.
