kumaokobo/kudox-keyboard/kudox-game/rev1/README.md

# Kudox Game Keyboard rev.1

The Kudox Game rev.1 is the Row-Staggered keyboard specialized for playing game.  
**Japanese Manual is [here](README.ja.md).**

<p align="center">
Kudox Game image
</p>

## Summary

  - [Bill of materials](#bill-of-materials)
  - [Assembly guide](#assembly-guide)
  - [Firmware](#firmware)

## Bill of materials

| Qty | Item | Notes |
|----:|---|---|
| 1 | Kudox Game PCB | |
|  26 | 1N4148 diodes | SMD diodes can also be used |
| 1 | Through hole momentary switch | Dimensions 6mm x 6mm x 4.3mm |
| 1 | Arduino Pro Micro | ATMega32U4 |
| 1 | USB micro cable | |
| 1 | Case | |
| 5 | Screws M3 x 10mm | M3 |
| 5 | Screws M3 x  5mm | M3 |
| 5 | Spacers | M3 |
| 5 | Nuts | M3 |
|  26 | Cherry MX compatible switches | |
|  26 | Cherry MX compatible keycaps | 3x 1.5u keycaps, 1x 2u keycap, 22x 1u keycaps |

[Kudox Game Basic](https://kumaokobo.booth.pm/items/1500316) is on sale at [BOOTH](https://kumaokobo.booth.pm/) (**NOT** including switches and keycaps).  

## Assembly guide

<p align="center">
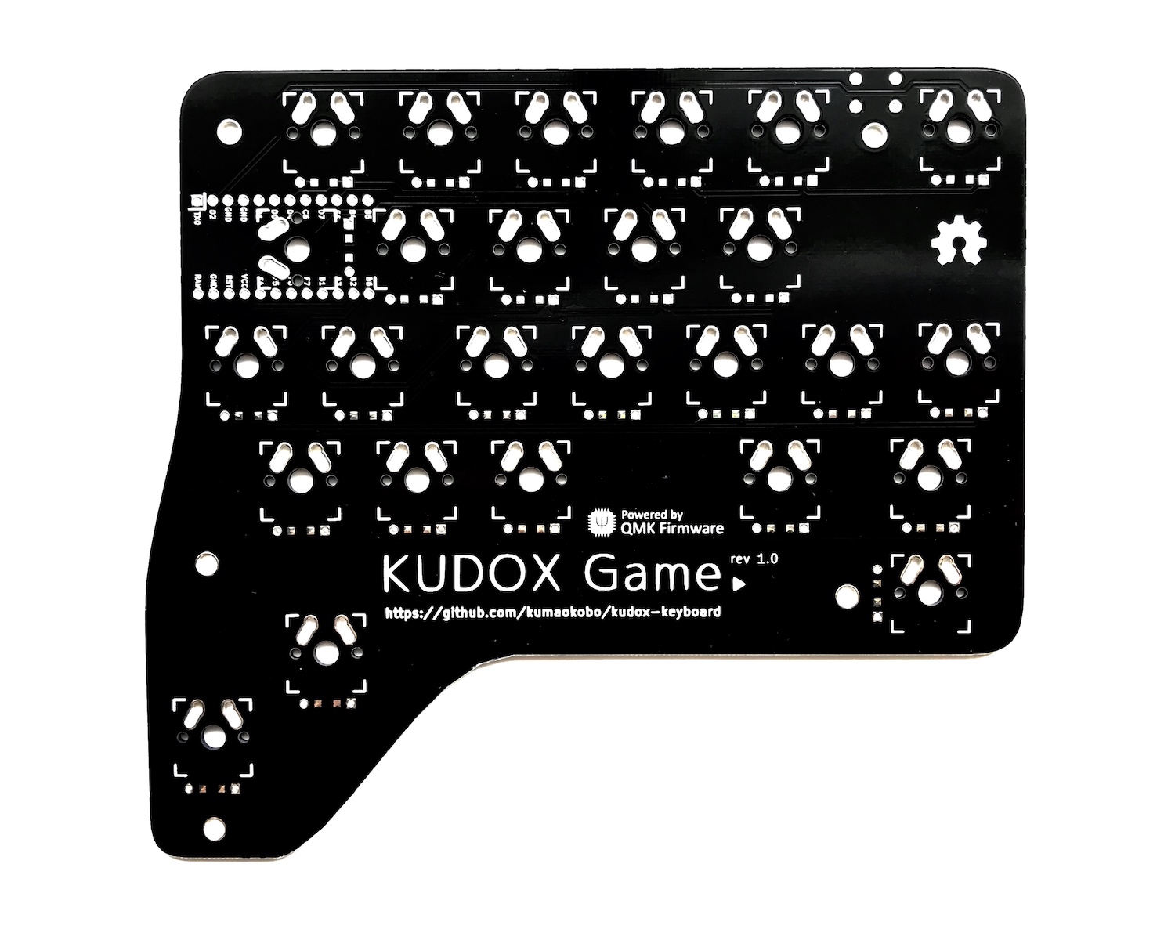
[picture p89: img/pcb-image-kudox-game-rev1.jpg]
Kudox Game PCB

</p>

### Installation steps:

- Solder components:
  1. Solder 1N4148 diodes. Put the cathode in the square hole.<br/><div>Kudox Game diode</div>
  2. Solder a momentary switch.
  3. Solder the Pro Micro header pins (**do not solder the Pro Micro controllers yet**).
- Install upper cases to PCBs.
  * M3x10 screws → upper case → M3 nuts → PCB → spacers.<br/><div>Kudox case</div>
- Fit switches to the upper cases and solder to the PCB.
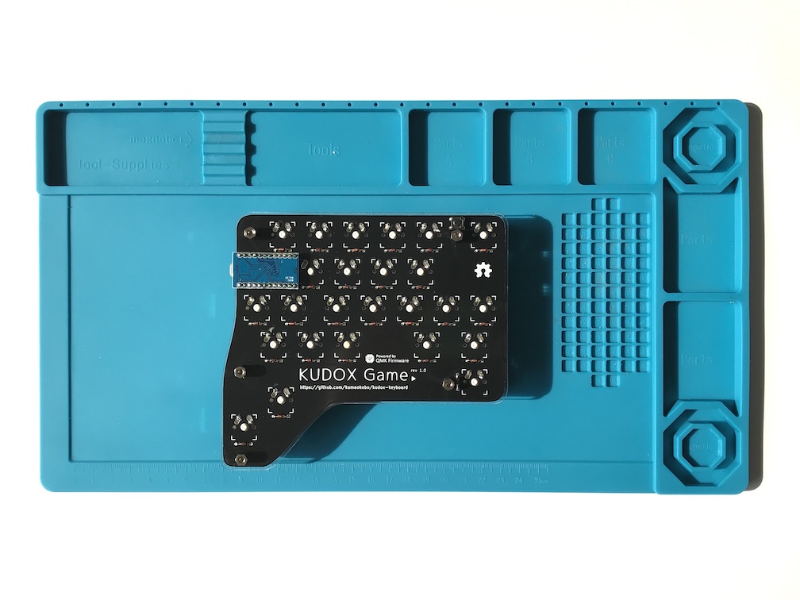
[picture p90: img/kudox-game-promicro.jpg]
Kudox Game ProMicro
- Solder Pro Micro to the header pins.<br/>

### Video guides

- [Inken ch](https://www.youtube.com/channel/UCXJZdip7JmW74HQHCtfYzFw) (japanese only)

<p align="center">
<a href="https://www.youtube.com/watch?v=f3dFaBmC-ak">Kudox Game組み立てガイド</a>
<a href="https://www.youtube.com/watch?v=HCa4KX-FlOU">Kudox Game Firmware</a>
</p>

## Firmware

<p align="center">
qmk
</p>

Kudox Game keyboard uses [QMK Firmware](https://github.com/qmk/qmk_firmware) for its firmware.  
Follow the QMK installation instructions [here](https://docs.qmk.fm/#/newbs_getting_started), then compile and burn the firmware as follows:  

```sh
$ cd path/to/qmk_firmware
$ make kudox_game/rev1:default:flash
```

## Layout

<p align="center">
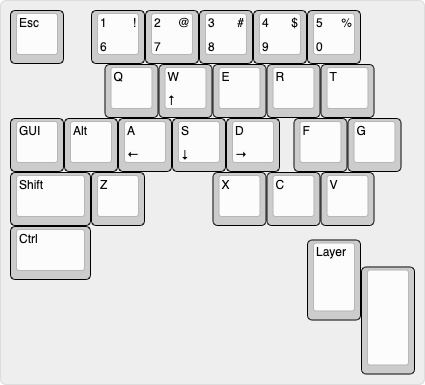
[picture p91: img/kudox-game-layout-rev1.png]
Kudox rev1.0 layout

</p>
<p align="center">
<em><a href="http://www.keyboard-layout-editor.com/">http://www.keyboard-layout-editor.com/</a></em>
</p>

- [KLE Layout permalink](http://www.keyboard-layout-editor.com/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)
