kumaokobo/kudox-keyboard/kudox/rev2/README.ja.md

# Kudox Keyboard Rev.2

Kudox Rev 2.0 は 66キーのホット・スワップ分離キーボードです.  
ホット・スワップ・ソケットのはんだ付けが必要なため、 Rev 1.0 に比べてやや組み立て難易度が上がります.  
また Rev 1.0 からキーが2つ増えました.  

**English Manual is [here](README.md).**

<div style="display:block;margin:50px auto;">
<p align="center">
Kudox rev2 image1
Kudox rev2 image2
</p>
</div>

## Summary

  - [必要な部品](#必要な部品)
  - [組み立てガイド](#組み立てガイド)
  - [LEDテープの取り付け](#LEDテープの取り付け)
  - [ファームウェア](#ファームウェア)
    - [基本書き込みコマンド](#基本書き込みコマンド)
    - [初回書き込み時](#初回書き込み時)
    - [JIS配列を書き込む場合](#JIS配列を書き込む場合)

## 必要な部品

| 数量 | 項目 | 備考 |
|----:|---|---|
| 2 | Kudox Rev2.0 PCB | |
|  66 | 1N4148 ダイオード | SMD ダイオードでも可. |
| 2 | PJ-320A 4極 3.5mm TRRS コネクタ | |
| 2 | 4.7 kΩ 抵抗 | 片側のPCBのみにはんだ付けします. |
| 2 | タクトスイッチ | 6mm x 6mm x 4.3mm サイズのもの. |
| 2 | Arduino Pro Micro | マイコン: ATMega32U4 |
| 1 | TRRS ケーブル | 4極のもの. (4極じゃないと正常動作しません) |
| 1 | USB micro ケーブル | 家に落ちているもので可. |
| 2 | ケース | |
|  10 | ネジ M3 x 10mm | |
|  10 | ネジ M3 x  5mm | |
|  10 | スペーサー | M3 x  7mm |
|  10 | ワッシャー | M3 のもの |
|  66 | [Kailh PCB Scoket](https://www.kailhswitch.com/mechanical-keyboard-switches/box-switches/mechanical-keyboard-switches-kailh-pcb-socket.html) | Cherry MX 互換タイプの方 |
|  66 | Cherry MX 互換 スイッチ | お好みで...💕 |
|  66 | Cherry MX 互換 キーキャップ | 4x 1.25u, 2x 1.75u, 2x 2.25u, 48x 1u |
|  14 | LEDテープ WS2812B | ※ オプションです. 7 LEDs x 2 |
|  7 | ビニール線 | ※ オプションです. LED を取り付ける場合に使います. |

キーキャップとスイッチ以外の全てを含む [Kudox rev2 基本セット](https://kumaokobo.booth.pm/items/1703779) を [BOOTH](https://kumaokobo.booth.pm/) にて販売しています.  

## 組み立てガイド

<p align="center">
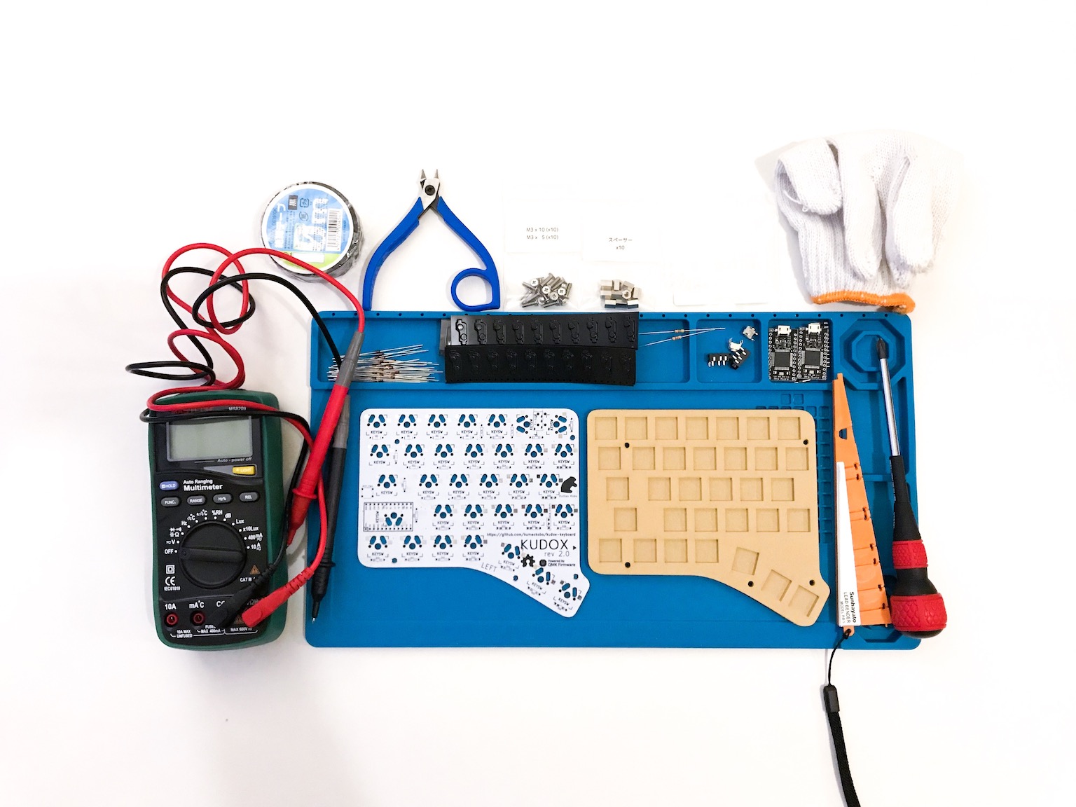
[picture p93: img/kudox-rev2-parts.jpg]
Kudox rev2 parts

</p>

- PCBに下記をはんだ付けします:
  1. 1N4148ダイオード (向きがあります. カソードが四角型の穴側にくるように差します)<br/><div>Kudox diode</div>
  2. PJ-320Aコネクタ
  3. タクトスイッチ
  4. 4.7 kΩ 抵抗 (左右どちらかのPCBのみにはんだ付けします)
  5. ホット・スワップ・ソケット<br/>はんだごてではんだ付けする場合:<div>soldering hot swap sockets</div>
  クリームはんだでリフローして頂いてももちろん大丈夫です.
  6. Pro Micro の ピン・ヘッダ  
  *Pro Micro のピン・ヘッダをはんだ付けする際には, Pro Microを使って位置合わせをすることをおすすめしております.*  
  *特にコンスルー対応のBlack Pro Microはチップがホット・スワップ・ソケットに当たりやすくなっていますので, ピン・ヘッダを少し浮かせてはんだ付けした方が安定します.*  
  *もしくは, Pro Microと重なる箇所だけホット・スワップ・ソケットにベリリウム銅を使用するのが良いかもしれません.*
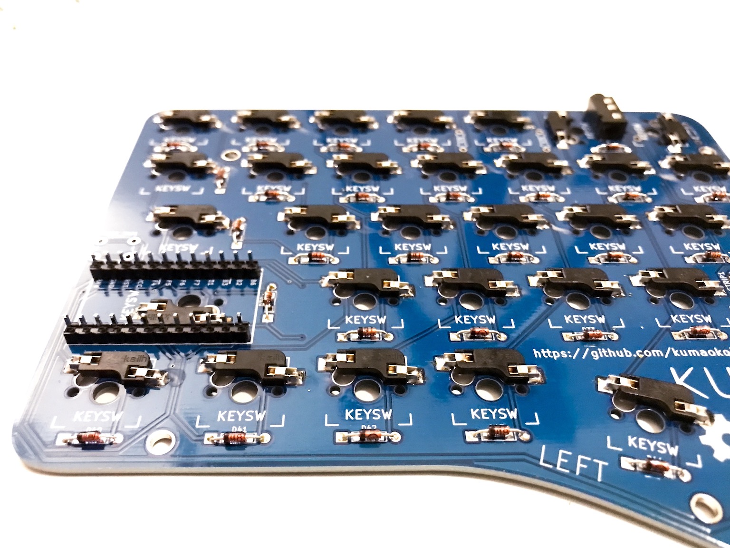
[picture p94: img/soldered-kudox-rev2.jpg]
soldered kudox rev2
  7. こんな感じになります:
- パーツの足をカットします.  
  *※ Pro Micro のピン・ヘッダとPJ-320Aコネクタはスイッチに干渉しやすいのでできるだけ短くカットしてください*<div>cuts pins</div>
- `RIGHT` と書いてある側に部品を実装したPCBは, チップ類がPCB側を向くように Pro Micro をはんだ付けするため, ホット・スワップ・ソケットがチップに干渉しないよう, 絶縁テープでガードします.<div>
  seal hotswap socket 1<span>&nbsp;</span>
  seal hotswap socket 2<span>&nbsp;</span>
  seal hotswap socket 3</div>
- Pro Micro を ピン・ヘッダにはんだ付けします.
  - `LEFT` と書いてある側: Pro Micro を表向き(チップが見えるように)にはんだ付けします.
  - `RIGHT` と書いてある側: Pro Micro を裏向き(チップ類がPCBに向くように)にはんだ付けします.<br/><div>Kudox ProMicro</div><span><em>※ 写真は `rev1` のものですが, Pro Micro の向きは `rev2` も同じです.</em></span>
- PCB に上部ケースを取り付けます.  
  M3ネジ(10mm) → 上部ケース → ワッシャー → PCB → スペーサー の順番に取り付けます.<br/><div>Kudox case</div>
- 下部ケースをスペーサーにネジ止めします.
- スイッチを嵌めて完成です.<div>
  assembly kudox rev2 case 1<span>&nbsp;&nbsp;</span>assembly kudox rev2 case 2
</div>

### Youtube: 組み立てガイド

- [インケンch](https://www.youtube.com/channel/UCXJZdip7JmW74HQHCtfYzFw)

<p align="center">
<a href="https://www.youtube.com/watch?v=6zZAXjMQ80E">Kudox組み立てガイド</a>
<a href="https://www.youtube.com/watch?v=HCa4KX-FlOU">Kudox Firmware</a>
</p>

動画ではちょっとしたコツなども紹介しています.  
*動画は `rev1` のものですが、ホットスワップ・ソケット以外は概ね同じです.*

## LEDテープの取り付け

▶ [こちら](LED.ja.md)をご覧ください.

## ファームウェア

<p align="center">
qmk
</p>

Kudox Keyboard は [QMK Firmware](https://github.com/qmk/qmk_firmware) を利用しています.  
QMK Firmware のインストールは [こちら](https://docs.qmk.fm/#/newbs_getting_started) をご覧ください.  

### 基本書き込みコマンド

```sh
$ cd path/to/qmk_firmware
$ make kudox/rev2:default:flash
```

### 初回書き込み時

初回書き込み時には、 左手・右手 両方の Pro Micro にファームを書く必要があります.  

#### 1. 左手側

[kudox/config.h](https://github.com/qmk/qmk_firmware/blob/master/keyboards/kudox/config.h) を編集して `MASTER_LEFT` を有効にします.

```cpp
/* Select hand configuration */
#define MASTER_LEFT
// #define MASTER_RIGHT
// #define EE_HANDS
```

保存したら、 **左手側** の Pro Micro と PC をUSBケーブルで接続し、 [基本書き込みコマンド](#基本書き込みコマンド) を実行します.

```sh
$ cd path/to/qmk_firmware
$ make kudox/rev2:default:flash
```

#### 2. 右手側

[kudox/config.h](https://github.com/qmk/qmk_firmware/blob/master/keyboards/kudox/config.h) を編集して `MASTER_RIGHT` を有効にします.

```cpp
/* Select hand configuration */
// #define MASTER_LEFT
#define MASTER_RIGHT
// #define EE_HANDS
```

保存したら、**右手側** の Pro Micro と PC をUSBケーブルで接続し、 [基本書き込みコマンド](#基本書き込みコマンド) を実行します.

#### 3. 動作確認

一度USBケーブルを外してから、 TRRSケーブルで左右をつなぎます.  
マスター側の Pro Micro にUSBケーブルをつなぎ、左右ともに文字入力可能なことを確認します.　　

以降、キー配列を変更した場合など再びファームを書く場合は、 TRRSケーブルをつないだままマスター側の Pro Micro に書き込みを行うことで、左右に設定が反映されるようになります.　　

### JIS配列を書き込む場合

[kudox/rev2/keymaps/jis](https://github.com/qmk/qmk_firmware/blob/master/keyboards/kudox/rev2/keymaps/jis/keymap.c) に JIS-like配列を置いていますが、[Qmk Firmware](https://github.com/qmk/qmk_firmware) の [keycodes](https://github.com/qmk/qmk_firmware/blob/master/docs/keycodes.md) を参考にご自身の使いやすいレイアウトに変更してお使いになられると良いかもしれません.  

```sh
$ cd path/to/qmk_firmware
$ make kudox/rev2:jis:flash
```

## レイアウト

### デフォルト

<p align="center">
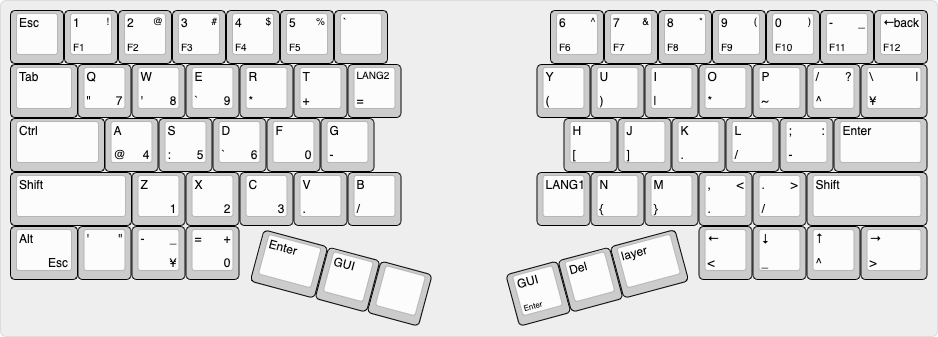
[picture p95: img/kudox-layout-rev2.png]
Kudox rev2.0 layout

</p>
<p align="center">
<em><a href="http://www.keyboard-layout-editor.com/">http://www.keyboard-layout-editor.com/</a></em>
</p>

- [KLE Layout permalink](http://www.keyboard-layout-editor.com/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'%0A%0A8&_f:3%3B&=E%0A%60%0A%0A9&_f:3%3B&=R%0A*&_f:3%3B&=T%0A+&_fa@:2%3B%3B&=LANG2%0A%2F=&_x:2.5&f:3%3B&=Y%0A(&_f:3%3B&=U%0A)&_f:3%3B&=I%0A%7C&_f:3%3B&=O%0A*&_f:3%3B&=P%0A~&_f:3%3B&=%2F%2F%0A%5E%0A%3F&_f:3&w:1.25%3B&=%5C%0A%C2%A5%0A%7C%3B&@_f:3&w:1.75%3B&=Ctrl&_f:3%3B&=A%0A%2F@%0A%0A4&_f:3%3B&=S%0A%2F:%0A%0A5&_f:3%3B&=D%0A%60%0A%0A6&_f:3%3B&=F%0A%0A%0A0&_f:3%3B&=G%0A-&_x:3.5&f:3%3B&=H%0A%5B&_f:3%3B&=J%0A%5D&_f:3%3B&=K%0A.&_f:3%3B&=L%0A%2F%2F&_f:3%3B&=%2F%3B%0A-%0A%2F:&_f:3&w:1.75%3B&=Enter%3B&@_f:3&w:2.25%3B&=Shift&_f:3%3B&=Z%0A%0A%0A1&_f:3%3B&=X%0A%0A%0A2&_f:3%3B&=C%0A%0A%0A3&_f:3%3B&=V%0A.&_f:3%3B&=B%0A%2F%2F&_x:2.5&f:3%3B&=LANG1&_f:3%3B&=N%0A%7B&_f:3%3B&=M%0A%7D&_f:3%3B&=,%0A.%0A%3C&_f:3%3B&=.%0A%2F%2F%0A%3E&_f:3&w:2.25%3B&=Shift%3B&@_f:3&w:1.25%3B&=Alt%0A%0A%0AEsc&_f:3%3B&='%0A%0A%22&_f:3%3B&=-%0A%0A%2F_%0A%C2%A5&_f:3%3B&=%2F=%0A%0A+%0A0&_x:8.5&f:3%3B&=%E2%86%90%0A%3C&_f:3%3B&=%E2%86%93%0A%2F_&_f:3%3B&=%E2%86%91%0A%5E&_f:3&w:1.25%3B&=%E2%86%92%0A%3E%3B&@_r:15&rx:5&y:4&x:0.75&f:3&w:1.25%3B&=Enter&_f:3%3B&=GUI&_a:7%3B&=%3B&@_r:-15&rx:12&y:4&x:-4&a:4&f2:1%3B&=GUI%0AEnter&=Del&_w:1.25%3B&=layer)

### JIS-like 配列

<p align="center">
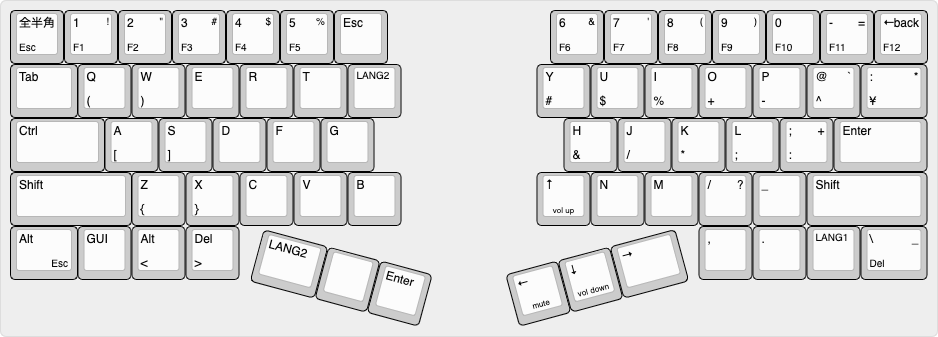
[picture p96: img/kudox-jis-rev2.png]
Kudox rev2.0 JIS layout

</p>
<p align="center">
<em><a href="http://www.keyboard-layout-editor.com/">http://www.keyboard-layout-editor.com/</a></em>
</p>

- [KLE Layout permalink](http://www.keyboard-layout-editor.com/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'&=8%0AF8%0A(&=9%0AF9%0A)&=0%0AF10&_f2:2%3B&=-%0AF11%0A%2F=&_f2:2%3B&=%E2%86%90%0AF12%0Aback%3B&@_w:1.25%3B&=Tab&_f:3%3B&=Q%0A(&_f:3%3B&=W%0A)&=E&=R&=T&_fa@:2&:2%3B%3B&=LANG2&_x:2.5&f:3%3B&=Y%0A%23&_f:3%3B&=U%0A$&_f:3%3B&=I%0A%25&_f:3%3B&=O%0A+&_f:3%3B&=P%0A-&_f:3%3B&=%2F@%0A%5E%0A%60&_f:3&w:1.25%3B&=%2F:%0A%C2%A5%0A*%3B&@_f:3&w:1.75%3B&=Ctrl&_f2:0%3B&=A%0A%5B&=S%0A%5D&=D&=F&=G&_x:3.5%3B&=H%0A%2F&&=J%0A%2F%2F&=K%0A*&=L%0A%2F%3B&=%2F%3B%0A%2F:%0A+&_w:1.75%3B&=Enter%3B&@_w:2.25%3B&=Shift&=Z%0A%7B&=X%0A%7D&=C&=V&=B&_x:2.5&fa@:0&:0&:0&:0&:0&:0&:0&:0&:0&:0&:1%3B%3B&=%E2%86%91%0A%0A%0A%0A%0A%0A%0A%0A%0A%0Avol%20up&=N&=M&=%2F%2F%0A%0A%3F&=%2F_&_w:2.25%3B&=Shift%3B&@_fa@:0&:0&:0&:2%3B&w:1.25%3B&=Alt%0A%0A%0AEsc&=GUI&=Alt%0A%3C&=Del%0A%3E&_x:8.5%3B&=,&=.&_fa@:2%3B%3B&=LANG1&_f2:2&w:1.25%3B&=%5C%0ADel%0A%2F_%3B&@_r:15&rx:5&y:4&x:0.75&w:1.25%3B&=LANG2&_a:7%3B&=&_a:4%3B&=Enter%3B&@_r:-15&rx:12&y:4&x:-4&fa@:0&:2&:2&:2&:2&:2&:2&:2&:2&:2&:1%3B%3B&=%E2%86%90%0A%0A%0A%0A%0A%0A%0A%0A%0A%0Amute&=%E2%86%93%0A%0A%0A%0A%0A%0A%0A%0A%0A%0Avol%20down&_w:1.25%3B&=%E2%86%92)
