kumaokobo/kudox-keyboard/kudox/rev2/LED.ja.md

# LEDテープ (WS2812B) の取り付けガイド

**English Guide is [here](LED.md).**

<div>
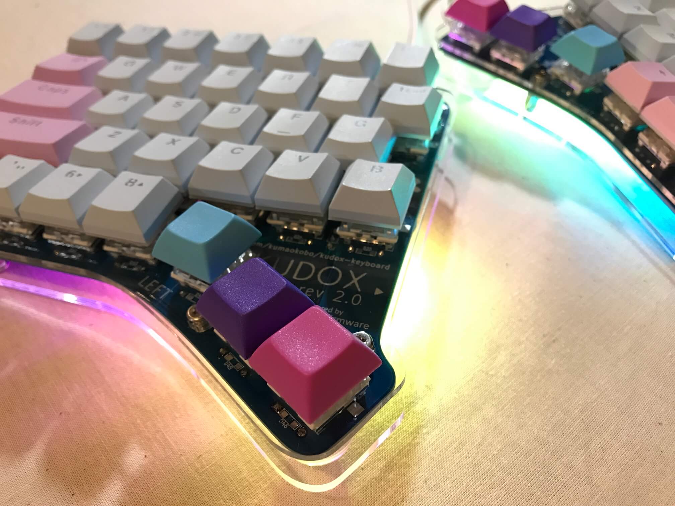
[picture p99: img/kudox_led.jpg]
Kudox led image

</div>

## 使用部品

<div>
led parts
</div>

- WS2812B LED 7玉 x 2本
- リード線 7本  
*内5本は先がコネクタになっているとベター*
- L型3ピンヘッダ x2
- 絶縁テープ
- はんだ付け済みPCB

このガイドでは下記のようにリード線を色分けして使っています.
```
VCC: 赤
GND: 黒
DIN: 黄
DO : 緑
```

**※ LEDテープを使う場合はKudox PCBに取り付けた抵抗をお外しください.**

## 1. LEDテープにリード線をはんだ付けします.

<div>led soldered</div>

1本目の LED の `5V` , `DIN` , `GND` に コネクタ付きリード線3本をはんだ付けします.  
1本目の LED の 逆サイドの `DO` に リード線1本をはんだ付けします.  
<br/>
2本目の LED の `DIN` に リード線1本をはんだ付けします.  
2本目の LED の 逆サイドの `5V` , `GND` にコネクタ付きリード線2本をはんだ付けします.  

> LEDテープのメッキ部分ははんだがのりにくいことが多いので, フラックスなどを使用するとはんだ付けが少し楽になります.

*LEDは熱に弱いため長時間高熱に晒すと壊れる場合があります.*  

## 2. はんだ付けした箇所を絶縁します.

<div>led insulation</div>

絶縁テープ(ビニールテープ)や熱収縮チューブなどではんだ付けした部分を絶縁します.  

## 3. TRRSコネクタにリード線をはんだ付けします.

<div>led wired&nbsp;&nbsp;led wired</div>

各LEDテープの `DO` , `DIN` にはんだ付けしたリード線の反対側ををTRRSコネクタの中央のパッドにはんだ付けします.

- 左手用 (実装面には `RIGHT` と記載): `5V` , `DIN` , `GND` に 3本のリード線をはんだ付けしたLEDテープを使います
- 右手用 (実装面には `LEFT` と記載): `5V` , `GND` に 2本のリード線をはんだ付けしたLEDテープを使います

下記のような信号の流れになります.  
```
左手 DIN -> LED -> DO -> TRRS -> 右手 TRRS -> DO -> LED
```

## 4. PCBにピンヘッダをはんだ付けします.

<div>led pin header</div>

L型3ピンヘッダ をPCBの `RGB` の箇所にはんだ付けします.  
ピンヘッダがダイオードにぶつからないよう, リード線のコネクタをピンヘッダに差し込んで位置合わせをしてください.

## 5. ピンヘッダにリード線を接続します.
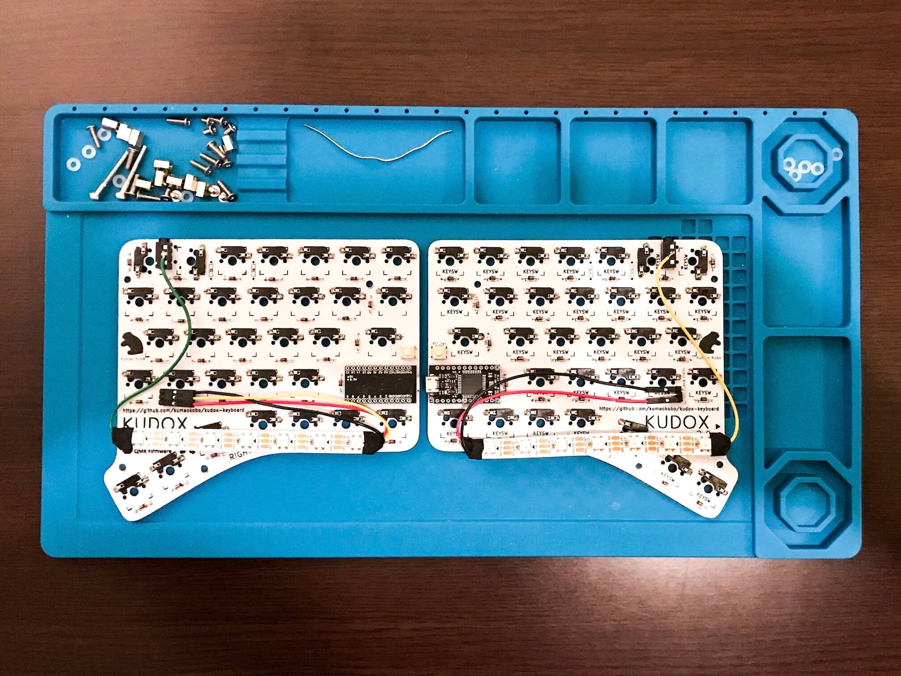
[picture p100: img/led-wired.jpg]
led wired


`RGB` ピンヘッダは、上から下記のように並んでいます.

```
GND
Data-IN
VCC
```

対応するリード線を接続してください.

---

これで完成ですが、 LEDテープが途中で断線していたりするとキー入力もできなくなります.  
ケースを組み立てる前に動作確認をすることをおすすめ致します.
