kumaokobo/kudox-keyboard/img/kudox-columner-pcb.jpg

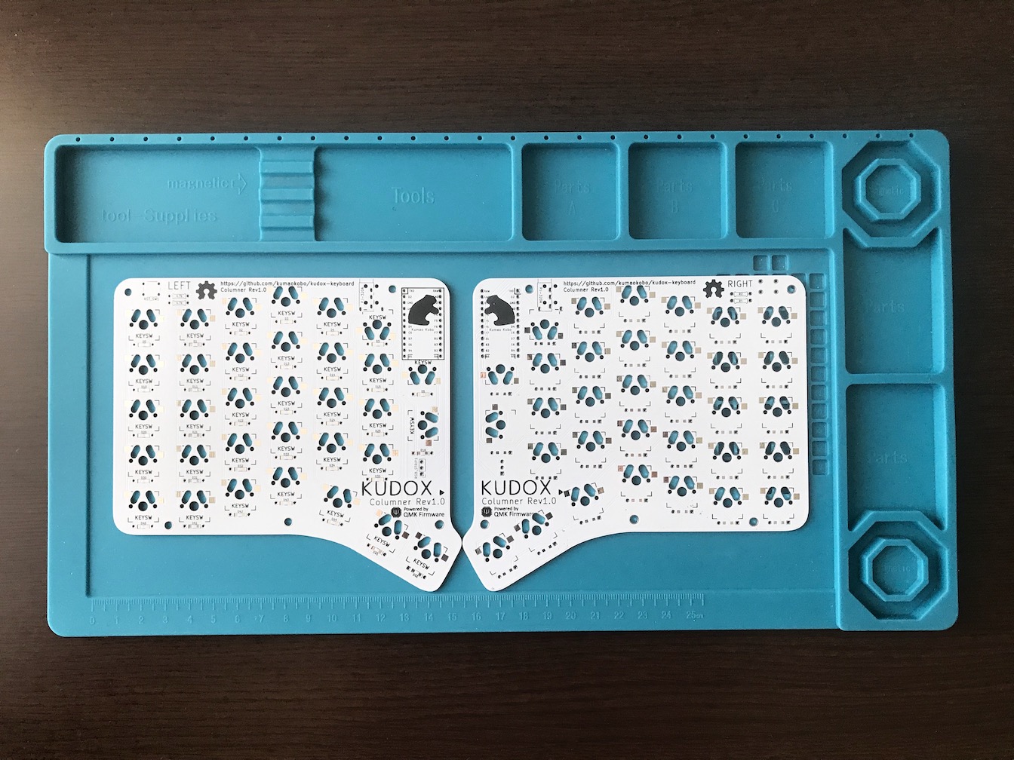
img/kudox-columner-pcb.jpg
