kumaokobo/kudox-keyboard/img/kudox-columner-thumb.jpg

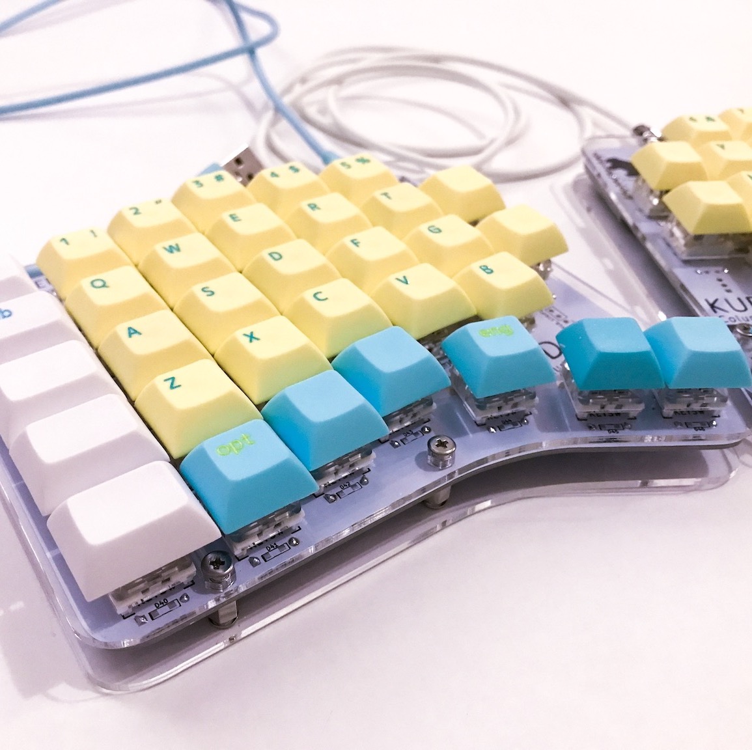
img/kudox-columner-thumb.jpg
