kumaokobo/kudox-keyboard/img/kudox-rev2-promicro.jpg

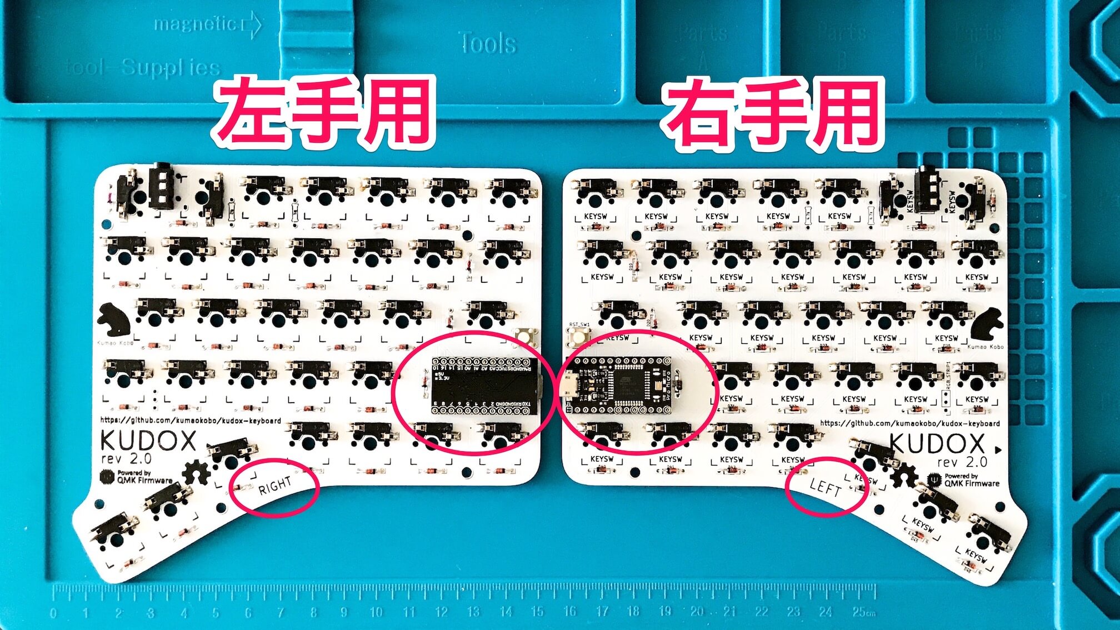
img/kudox-rev2-promicro.jpg
