kumaokobo/kudox-keyboard/img/pcb-image-kudox-rev1.jpg

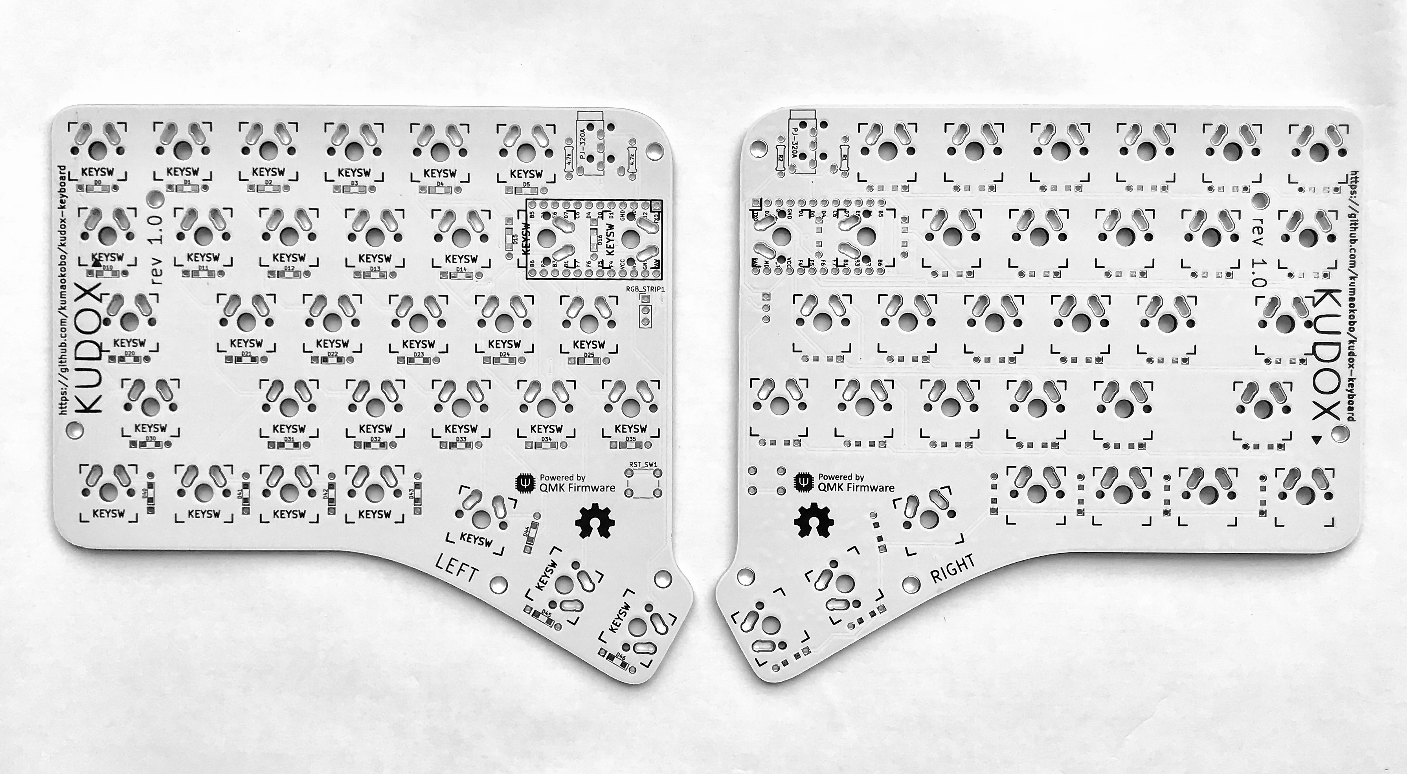
img/pcb-image-kudox-rev1.jpg
