kumaokobo/kudox-keyboard/img/youtube-qr-kudox-game-rev1-1.png

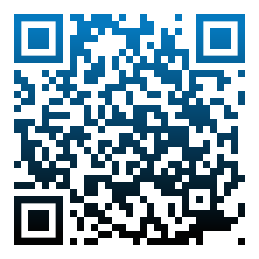
img/youtube-qr-kudox-game-rev1-1.png
