kumaokobo/kudox-keyboard/img/youtube-qr-kudox-game-rev1-2.png

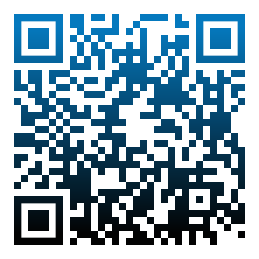
img/youtube-qr-kudox-game-rev1-2.png
