kumaokobo/kudox-keyboard/img/youtube-qr-kudox-rev1-1.png

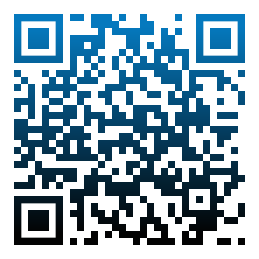
img/youtube-qr-kudox-rev1-1.png
