kumaokobo/kudox-keyboard/img/kudox-full-soldered-direct.jpg

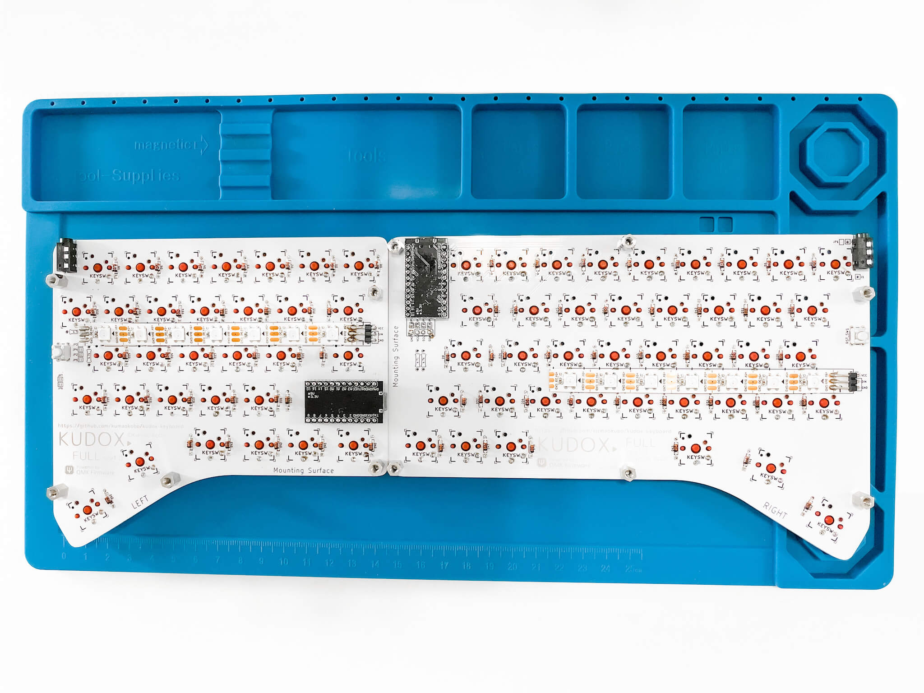
img/kudox-full-soldered-direct.jpg
