kumaokobo/kudox-keyboard/kudox-game/rev2/schematic.pdf

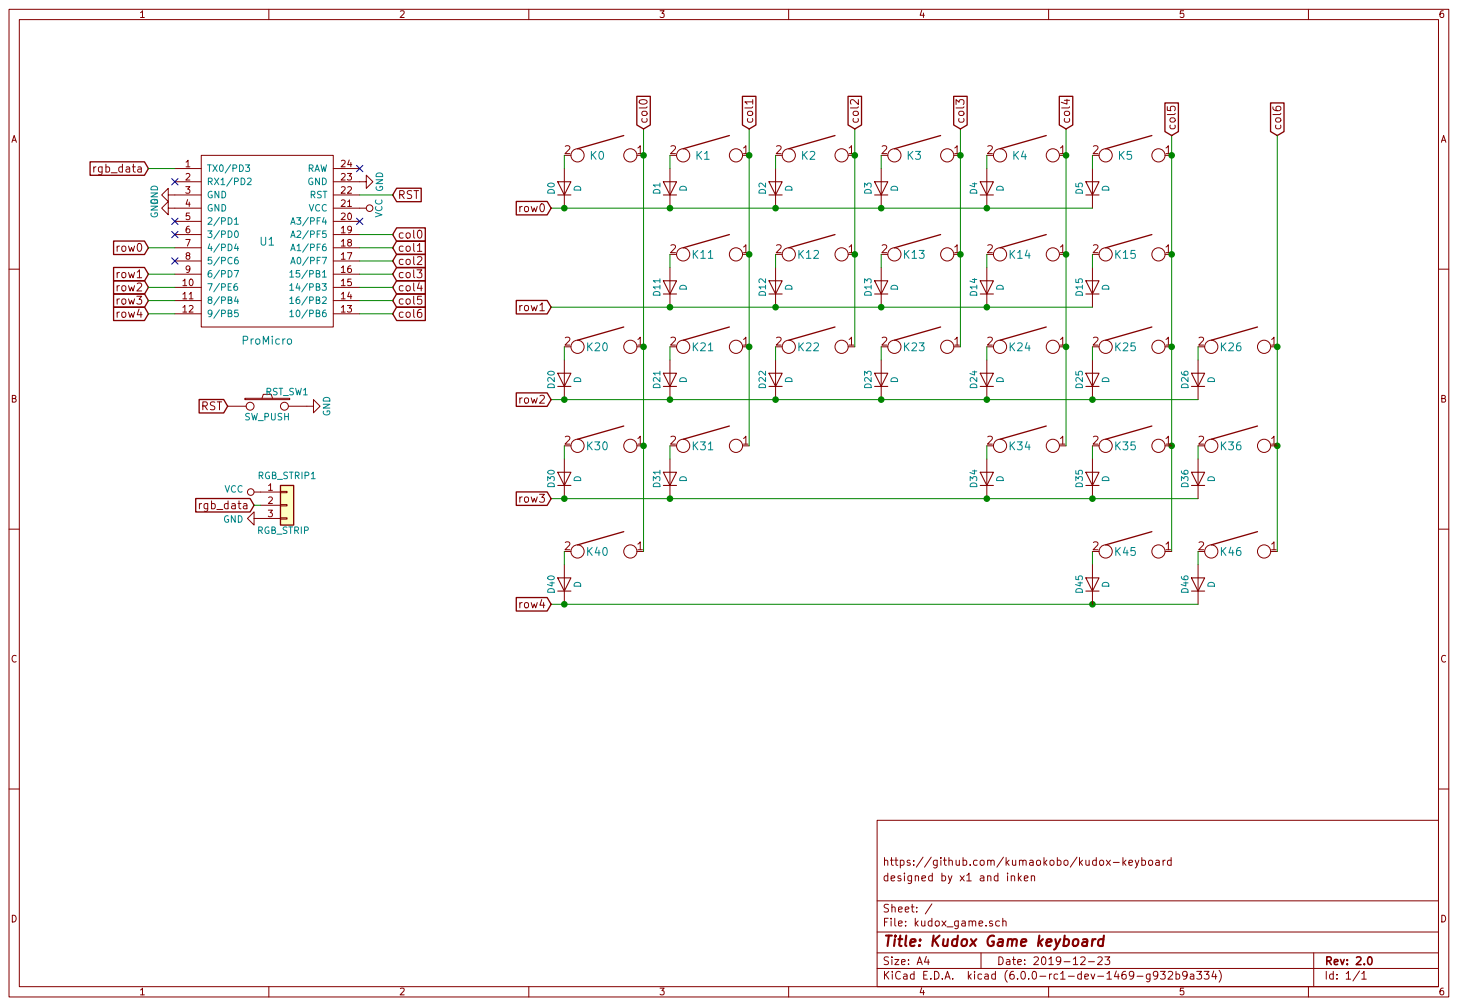
[picture p110: page 1]

https://github.com/kumaokobo/kudox-keyboard
File: kudox_game.sch Sheet: / designed by x1 and inken

Id: 1/1 Title: Kudox Game keyboard
