kumaokobo/kudox-keyboard/kudox-full/rev1/schematic/kudox-full-L.pdf

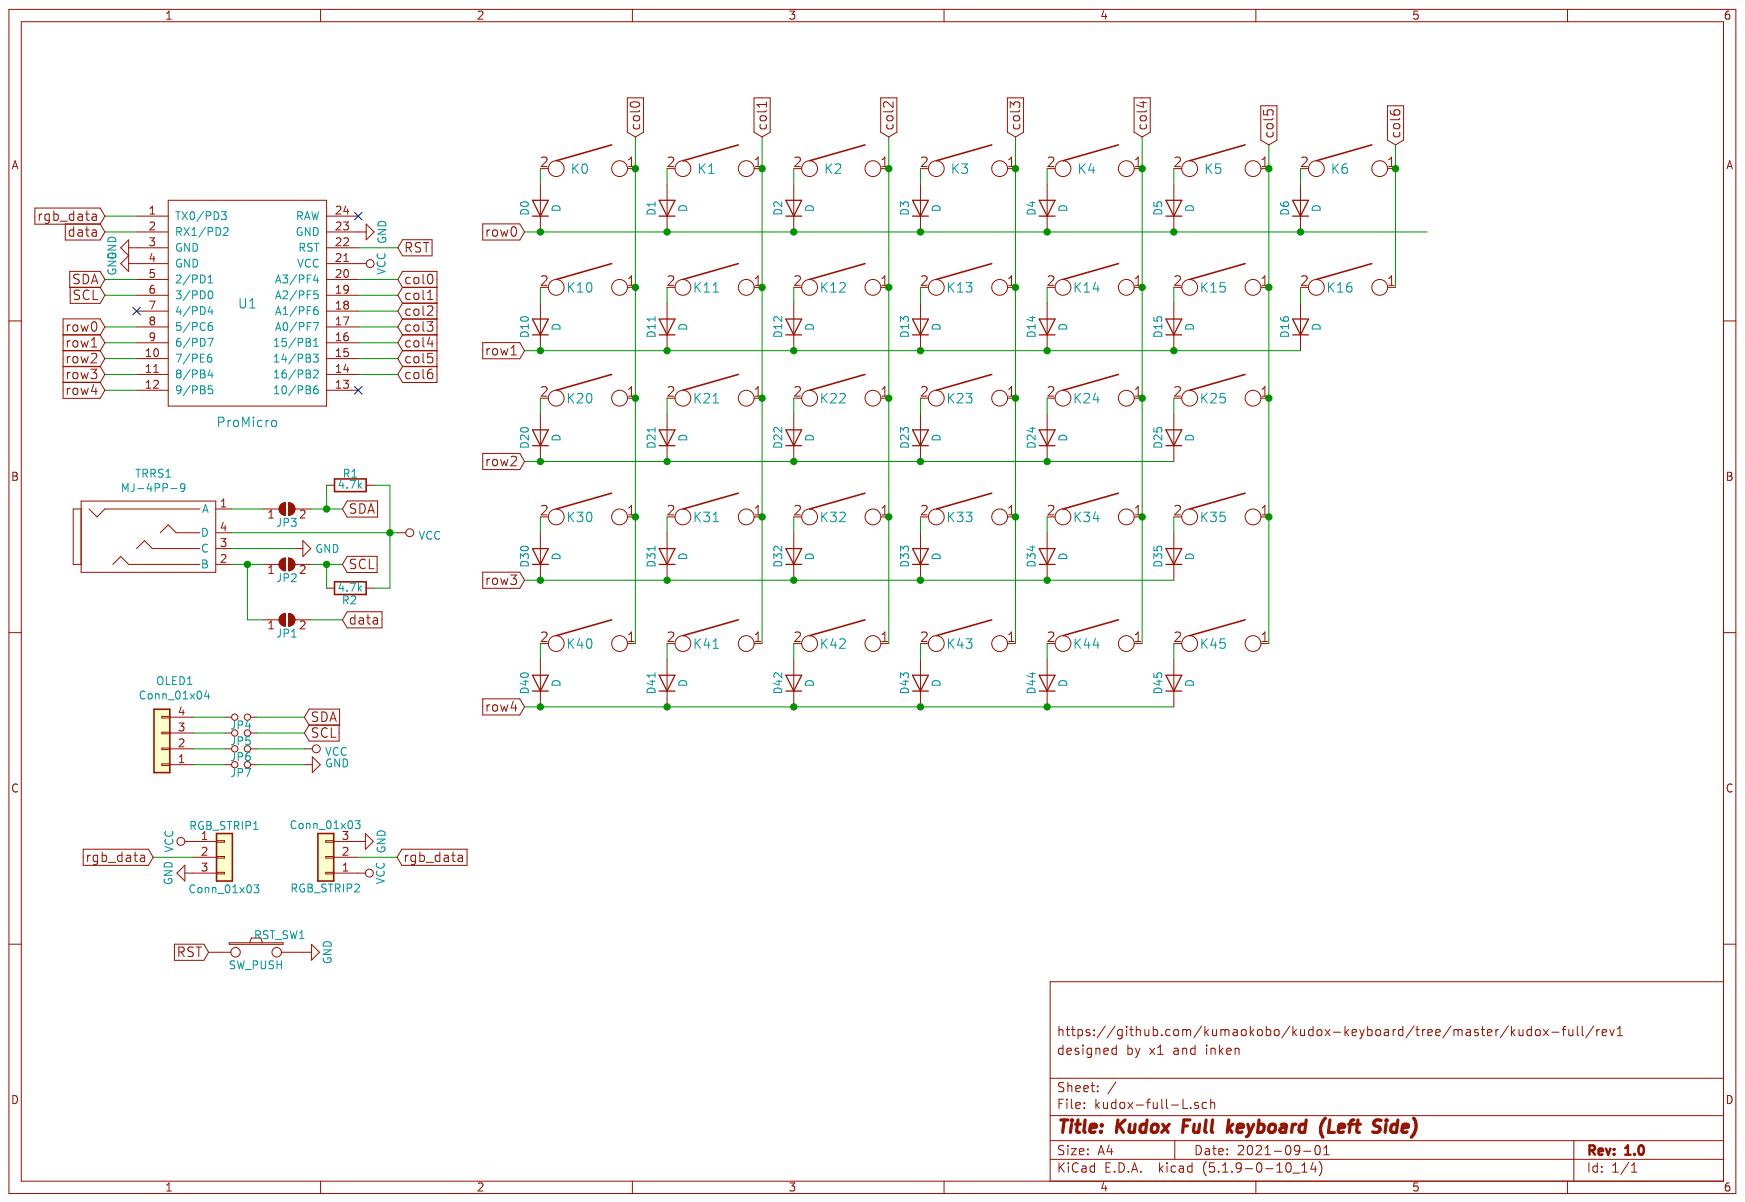
[picture p111: page 1]
