kumaokobo/kudox-keyboard/kudox-full/rev1/schematic/kudox-full-R.pdf

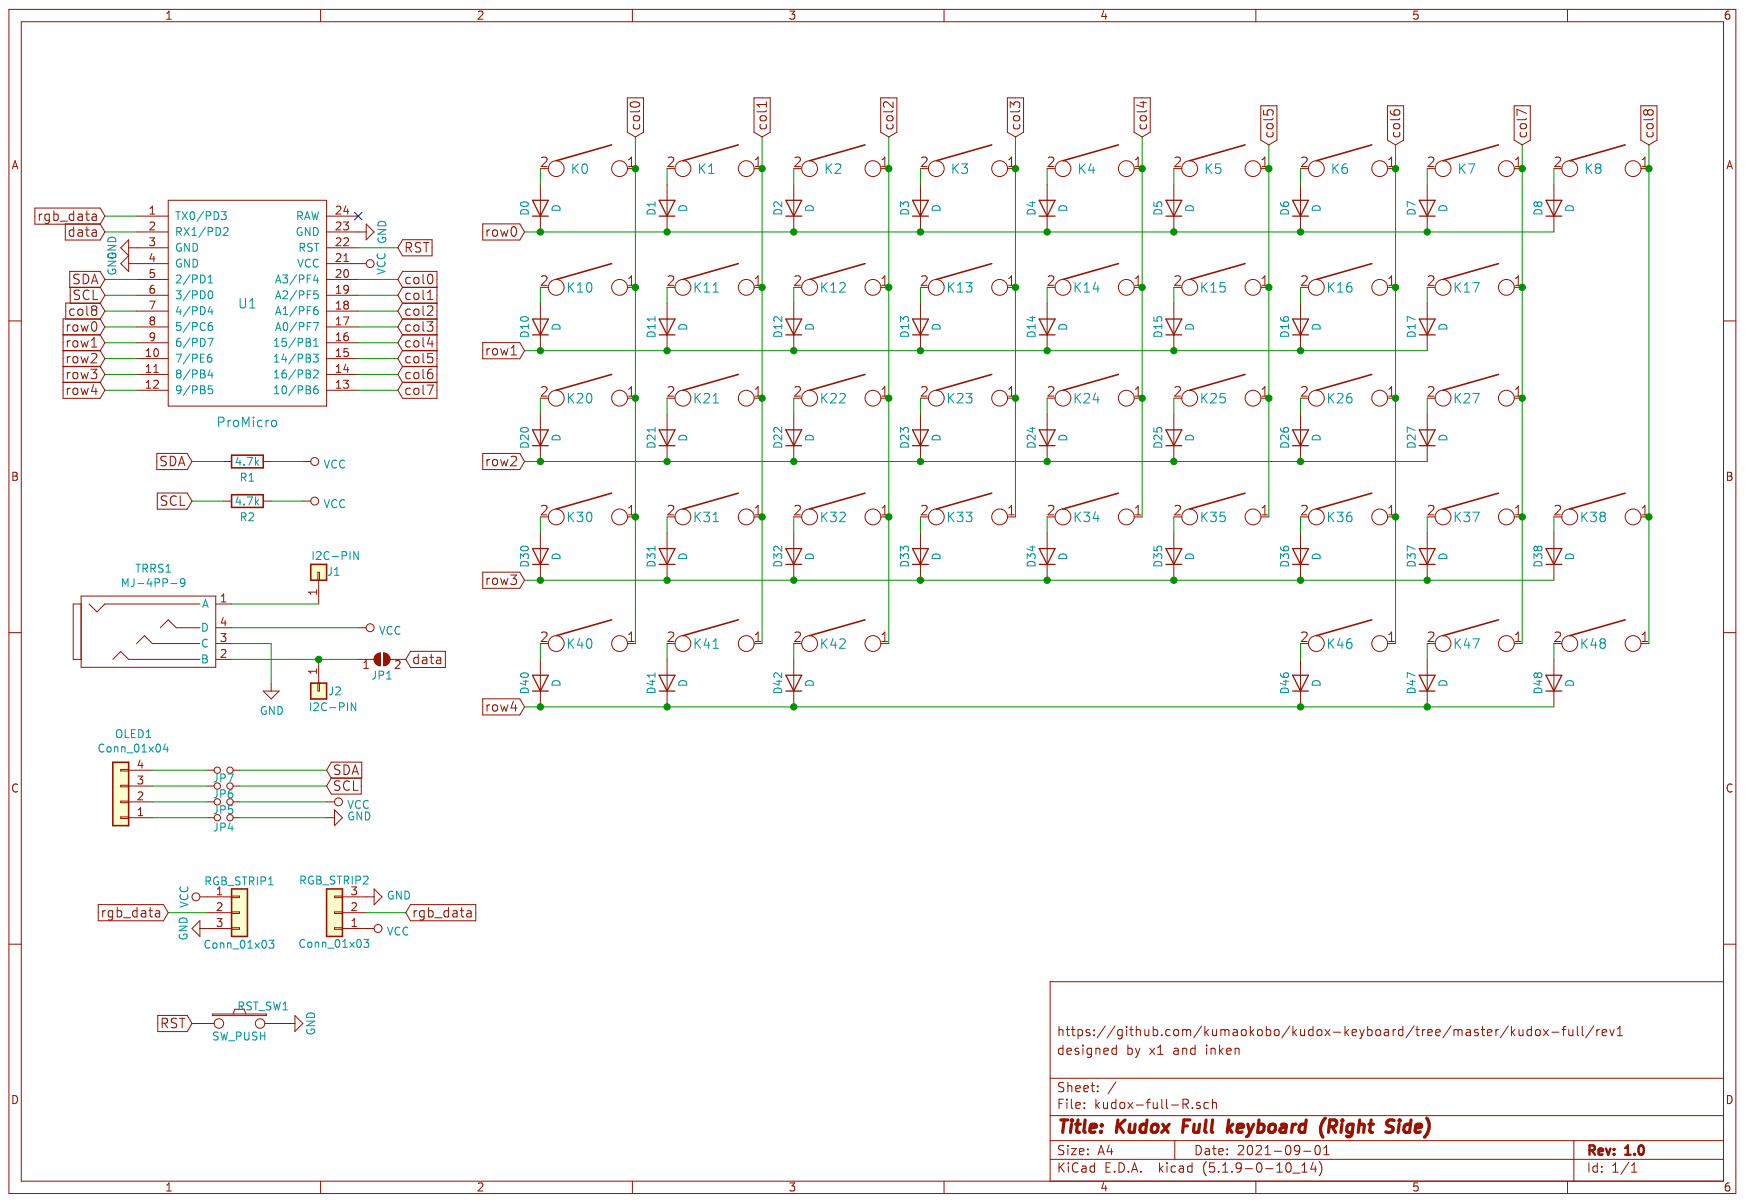
[picture p112: page 1]
