kumaokobo/kudox-keyboard/kudox/rev3/schematic/kudox_left.pdf

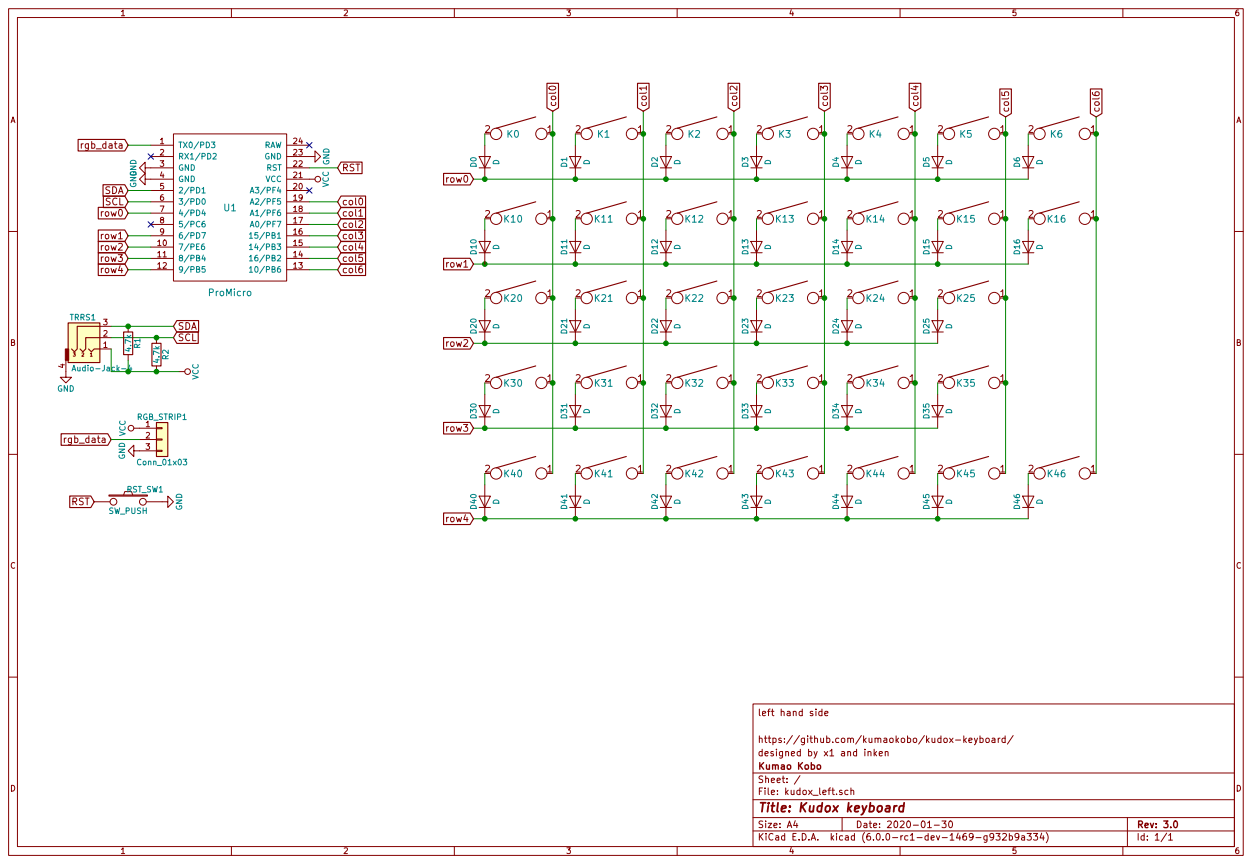
[picture p113: page 1]

https://github.com/kumaokobo/kudox-keyboard/
designed by x1 and inken
File: kudox_left.sch Sheet: / Kumao Kobo

Id: 1/1 Title: Kudox keyboard
