kumaokobo/kudox-keyboard/kudox/rev1/schematic.pdf

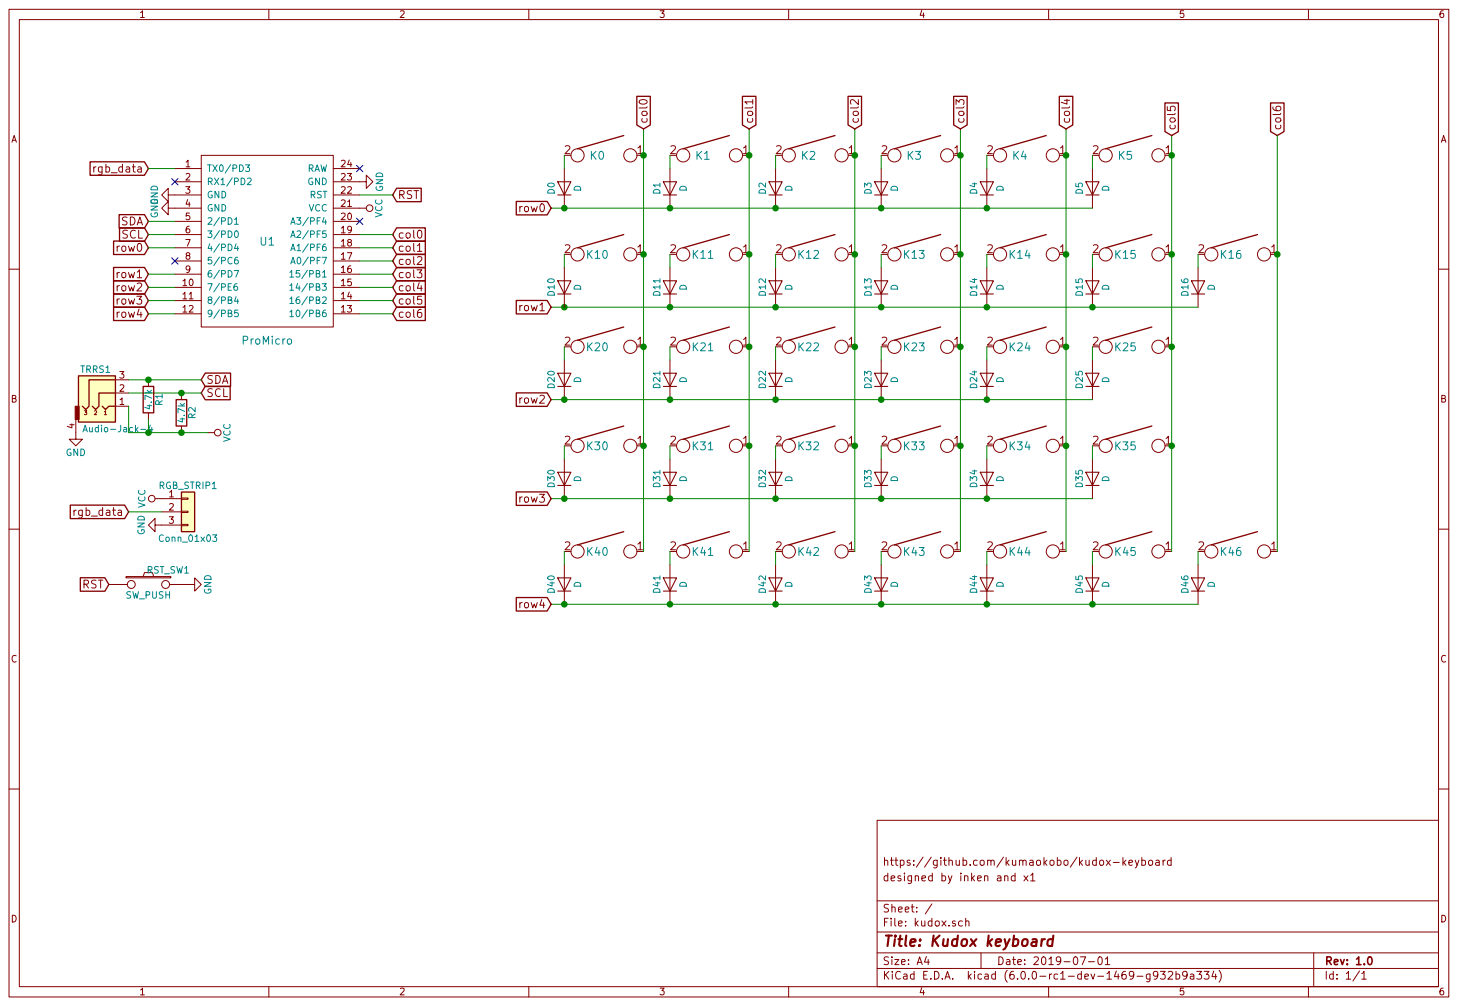
[picture p115: page 1]

https://github.com/kumaokobo/kudox-keyboard
File: kudox.sch Sheet: / designed by inken and x1

Id: 1/1 Title: Kudox keyboard
