kumaokobo/kudox-keyboard/(commit log)

2019-07-02 [game] Modified outlines and silk backboard. (#1)
    * Modified outlines and silk backboard.
    * Remove obsoleted files.
    * Modified logos and url of Kudox Game on silk.
    * Modified kudox for gerbar files.
    [cp.kicad_pcb, kudox-2019-06-29-19-21-44.sch, kudox.kicad_pcb, kudox.sch, kudox_game-2019-06-30-12-53-42.sch, kudox_game-2019-06-30-12-55-39.sch, kudox_game.kicad_pcb, kudox_game.sch]
2019-07-14 [kudox-game] Fix empty schematic of kudox game. (#2)
2019-07-15 [kudox-game] Add kudox game pcb image. (#3)
2019-07-15 [kudox-game] Modified kudox game pcb image size. (#4)
2019-07-16 [kudox-game] Modified the silks of Kudox Game PCB. (#7)
    [kudox_game.kicad_pcb, kudox_game.sch]
2019-07-16 [kudox] Fix lack of wiring at D21 on Kudox PCB. (#8)
    [kudox.kicad_pcb]
2019-07-16 [kudox-game] Modified schematic of Kudox Game. (#9)
2019-08-01 [kudox & kudox-game] Modified README. (#10)
    * Modified README.
    * Add README.ja.md.
    [KudoxBottomLeft.STL, KudoxBottomRight.STL, KudoxTopLeft.STL, KudoxTopRight.STL, kudox.blend, kudox_game.blend, kudox_gawa.dxf, kudox_gawa_dake.dxf]
2019-08-07 [kudox & kudox-game] Modified the assembly guides. (#14)
2019-08-07 [kudox & kudox-game] Add assembly images. (#15)
2019-08-30 [kudox & kudox-game] Modified settings of KiCad libraries. (#20)
    [kudox.sch, kudox_game.sch]
2019-09-11 [kudox & kudox-game] Add schematic symbols. (#21)
2019-11-06 Version up kudox rev1.1 (#23)
    * Modified Swappable Footprint for keys.
    * Remove the files should not be commited.
    * Write tracks.
    * Write all tracks.
    * Revert Alps Mx Switches.
    * Modified tracked wires.
    * Version up rev1.1.
    * Modified VCC track wires.
    * Modified the switch rotation on ProMicro.
    [kudox.kicad_pcb, kudox.sch]
2019-11-06 [kudox & kudox-game] Modified dir layout. (#24)
    * Rename images as rev1.
    * Move kudox/* to kudox/rev1.
    * Move kudox-game/* to kudox-game/rev1.
    * Modified READMEs.
    [kudox.kicad_pcb, kudox.sch, kudox_game.kicad_pcb, kudox_game.sch]
2019-11-07 [kudox] Add kudox rev2 (#25)
    * Add kudox rev2.
    * Add READMEs about Rev.2 and modified original README..
    * Modified image link on README.
    [kudox.kicad_pcb, kudox.sch]
2019-11-18 [columner] Add kudox colmner as a new layout keyboard (#26)
    * Add schematic of Kudox Columner.
    * Add kudox columner image file.
    [kudox-columner.kicad_pcb, kudox-columner.sch]
2019-12-03 Modified description for shielding hotswap sockets. (#31)
2019-12-25 [kudox] Add kudox rev2 pcb with silver/gold images. (#32)
    * Add image-pads for silver or gold images.
    * Add kudox rev2 pcb with silver/gold images.
    * Modified product images of kudox rev1.
    [kudox.kicad_pcb, kudox.sch]
2019-12-25 [kudox-game] Modified alignments of some switches. (#33)
    [kudox_game.kicad_pcb]
2020-01-08 Modified the position of LED pin header. (#34)
    [kudox.kicad_pcb]
2020-01-15 [kudox/rev2] Add assembly guide of LED (#35)
    * Add assembly guide of LED.
    * Modified building case using washers instead of nuts.
    * Add links to each languages.
    * Add summary assembly LED strips.
    * Modified Kudox rev2 images.
    * Revert images.
2020-01-22 [kudox] Modified assembly guide of LED. (#36)
    * Modified assembly guide of LED.
    * Add an image for pin header.
    * Add an image for Pro Micro.
2020-01-27 [kudox] Modified README of kudox rev2 using beryllium coppers as hot swap sockets. (#37)
2020-03-21 [kudox-game] Add kudox game rev2 compatible with hot-swap sockets (#38)
    * Add Kudox Game rev2 using Hot Swap Sockets.
    * Modified LOGO from silk to metal paste.
    * Modofied Kudox Game key layout image.
    * Modified READMEs of Kudox Game rev1 /w rev2.
    * Modified the explains.
    [kudox_game.kicad_pcb, kudox_game.sch]
2020-03-25 [kudox-game] Add LED underglow installation guide on Kudox Game Rev2. (#39)
2020-03-28 [kudox] Add kudox rev3 (#41)
    * Add footprints on Kudox Rev3.
    * Add KiCad file for Kudox Rev3.
    * Add schematic of Kudox Rev3.
    * Modified Kudox rev2 README.
    * Add Kudox rev3 images.
    * Add Kudox rev3 READMEs.
    * Add explains for stabilizer.
    * Modified READMEs slightly.
    * Add stabilizers in Bill of Materials.
    [kudox_left.kicad_pcb, kudox_left.sch, kudox_right.kicad_pcb, kudox_right.sch]
2020-03-28 [kudox] Remove Kudox rev2g. (#42)
    [kudox.kicad_pcb, kudox.sch]
2020-04-09 [kudox] Modified kudox rev3 pcb (#43)
    * Modified switch mounting holes for 5 pins.
    * Modified pcb slightly.
    * Add about online GUI configurator on READMEs..
    * Modified Top README.
    [kudox_left.kicad_pcb, kudox_right.kicad_pcb]
2020-08-03 [kudox-game] Modify Kudox Game rev2 using MX socket optional switch foot print. (#45)
    [kudox_game.kicad_pcb, kudox_game.sch]
2020-11-23 [kudox-game] Modify angle of LED strip hole on kudox-game (#50)
    [kudox_game.kicad_pcb]
2021-01-31 [columner] Modify footprints of switches on kudox-columner (#51)
    [kudox-columner.kicad_pcb]
2021-08-12 [kudox-columner] Modify kudox-columner to add RGB pad (#53)
    [kudox-columner.kicad_pcb, kudox-columner.sch]
2021-08-12 [kudox] Modify kudox/rev3 to add RGB pad (#54)
    [kudox_left.kicad_pcb, kudox_left.sch, kudox_right.kicad_pcb, kudox_right.sch]
2021-11-18 [kudox-full] Add documents for kudox full keyboard (#55)
    * Add documents for kudox full keyboard
    * Modify README of LED
    * Modify liks on README
    * Add images of OLED
    * Add the description for LED Underglow
    * Modify sizes of images
    * Add json of kudox-full for VIA
2022-02-03 [kudox] Compatible with ProMicro Type-C (#59)
    [kudox_left.kicad_pcb, kudox_left.sch, kudox_right.kicad_pcb, kudox_right.sch]
